jacob-rn-wallace/maha-rover/docs/images/viewshed-ring-preview.png

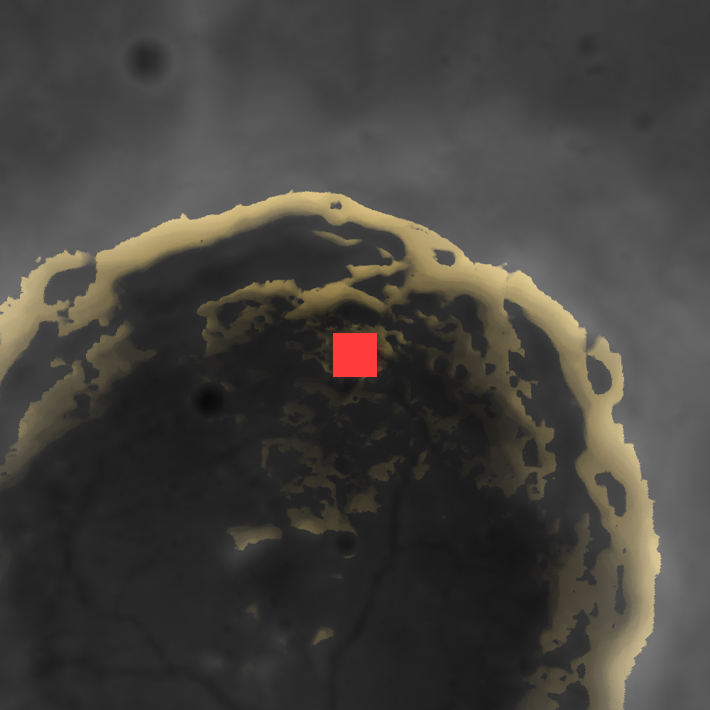
docs/images/viewshed-ring-preview.png
