jacob-rn-wallace/maha-rover/docs/sim-spec.md

# Browser simulation of al-maha on the lunar surface

**Goal (owner, 2026-11-08):** nothing can be bought or physically tested for the foreseeable future, so the current goal is a
high-fidelity simulation of the rover on the lunar surface that anyone can run and drive in a browser from GitHub (in spirit
like PUTvision/LunarSim, which is a Unity and ROS 2 Linux binary; this one is a static web page). Fidelity first, then
optimisation, then phones (owner's order).

## Architecture (decided by the assistant, owner deferred the choice)
| Part | Choice | Why |
|---|---|---|
| Rendering | three.js (WebGL2) | mature, runs on GitHub Pages as a static site, glTF native |
| Physics | Rapier (WASM, `@dimforge/rapier3d-compat`) | deterministic, fast, revolute and prismatic joints, heightfield and trimesh colliders, runs in a worker later |
| Model | glTF binary exported from the build123d CAD | the CAD stays the single source of truth: `hardware/sim/export_sim.py` |
| Build | Vite + TypeScript, built by `.github/workflows/pages.yml` | repo Settings > Pages > Source "GitHub Actions" is the one manual step |
| Fidelity-critical models | written in TypeScript, unit-checked against the docs | wheel-soil contact, the differential, the motor, power, camera |

## What is in the repo now (phase 1)
- `hardware/sim/export_sim.py` splits the assembly (187 parts, 50.9k triangles) into 9 rigid bodies and writes
  `sim/public/rover.glb` (1.7 MB) and `sim/public/rover.json` (joints, masses, centres of mass, inertia, camera).
  Bodies: chassis; link plate L and R (each with its two motors and a differential side gear); four wheels; mast pan; camera head.
  Body masses come from `hardware/mass/replica.py` (total 9.58 kg, as `docs/replica-mass.md`), the inertia from the meshes at uniform density.
- `sim/` is the web app: it loads the model on a placeholder plane and exercises every joint (pan, tilt, differential links, wheels).
- Axes: glTF Y up, metres; rover X forward stays X, rover Y (left) becomes -Z, rover Z (up) becomes Y.

## Visual layer (not in the CAD checks or the mass budget)
`hardware/sim/export_sim.py` and `hardware/sim/detail.py` add detail to the exported model only, so the CAD, its fit checks and the 9.58 kg estimate stay as they are:
- T-slot profiles (20 x 20, 20 x 40, 40 x 40: slots, diagonal webs, bore) in place of the plain extrusion boxes, with drilled holes kept; typical catalogue slot sizes, ASSUMPTION.
- Real-world materials by part (cast and sheet aluminium, anodised T-slot, black plastic, black cord, glossy dark cells, ASA wheels); the finishes are ASSUMPTIONS.
- Head and base: rounded vertical edges and a lid seam on the pan base box (seam 15 mm below the top, Takachi cover height) with four lid screws; a lid seam 10 mm behind the front face of the camera box (ASSUMPTION, not from the drawing); a PG7 hex gland with a domed cap nut; the lens with a grooved focus ring, front glass and retaining ring; two M5 bolts through the bracket web (positions ASSUMPTION).
- No Rashid-only features are added (owner, 2026-11-08).

## Lunar look (`sim/src/lunar.ts`, first version)
A low sun (14 degrees elevation, a parameter), hard shadows from a 4096 shadow map, a black sky with 4000 seeded stars, a reflection environment of black sky over sunlit regolith (so metals reflect the ground and not a room), and a flat
ground with procedural multi-scale regolith albedo and bump. Look-development values, not measurements: the albedo (about 0.12 to 0.2 effective) and the sun and exposure settings are choices. No craters, rocks or relief yet (phase 3's terrain), no earthshine, no dust.

## Phase 2: driving physics (done 2026-11-08, `sim/src/physics.ts`)
Rapier at 480 Hz fixed steps, lunar gravity 1.62 m/s2, flat ground. Nine rigid bodies from `rover.json`, with the CAD's mass, centre of mass and inertia tensor (mesh-derived, uniform density).
- **Differential:** the two link plates are separate revolute joints on the chassis, coupled by a stiff spring and damper so that angle L + angle R = 0 (k = 600 N.m/rad, c = 6 N.m.s/rad, tuned for critical damping of the sum mode; not gears, so friction and backlash are not modelled).
- **Drive:** each wheel has the Pololu 37D #4746 model from `docs/drive-spec.md`: R = 12 V / 5.5 A = 2.18 ohm, back-EMF constant 0.0111 V.s/rad from 76 rpm and 0.2 A no load, gearbox efficiency 0.75 (the value the datasheet's 0.59 N.m at 0.74 A implies), 7.4 V pack, current cap 1.6 A, shorted-terminal braking at zero duty. The motor rotor's inertia seen through the 131:1 gearbox (0.017 kg.m2, from an ASSUMED 1e-6 kg.m2 rotor) is added to each wheel.
- **Wheels:** collision shapes from the CAD mesh: a rim cylinder and 14 convex grouser hulls (plates thickened from 0.8 to 3 mm to stop tunnelling). Wheels collide with the ground only. Ground friction 0.8 and wheel 0.9 are the flat-plane placeholders (`?flat=1`); on the terrain the soil model below replaces them.
- **Mast:** pan (limit +-160 degrees, the design's 320 degree stop) and tilt (+-90) servos as PD loops, torque capped at the STS3215's 1.91 N.m stall, target slewed at its 52 rpm no-load speed; gains are tuning choices. The mast and head have no collision shapes yet.
- **Chassis collision:** the convex hull of the fixed structure on a 6 mm grid.

Scripted check (`?test=1`, 7.4 V, flat ground, grouser tip radius 115 mm):
| test | result |
|---|---|
| parked 5 s | still: 0.001 m/s, motor currents under 0.03 A |
| full throttle 6 s | steady 0.53 m/s |
| brake from speed | stops in about 1 s, no tipping |
| full turn command | spins in place at 102 deg/s (clockwise for a right turn), about 35% wheel slip |
| mast pan and tilt | reach +160 and +90 degrees |

**What the first runs showed about the design:**
- **Speed:** 0.53 m/s at full duty, above `drive-spec.md`'s 0.49 m/s no-load figure, because that used the 100 mm rim radius and the wheel rolls on its 115 mm grouser tips on hard ground (derived: 47 rpm x 0.115 m x 2 pi = 0.566 m/s before slip). On soft soil the effective radius will be smaller.
- **Braking tips the rover:** it tips nose-over if it decelerates harder than about 0.68 x g = 1.1 m/s2 on the Moon (CAD centre of mass z 235 mm, x +23 mm, half wheelbase 136.5 mm; the threshold scales with g). With zero duty the 37D shorts its terminals and a full brake through the 1.6 A cap is about 5 m/s2; the first test flipped to pitch -100 degrees. The sim limits duty change to 1.5 per second (about 0.8 m/s2). The real motor controller firmware needs the same deceleration limit; this is a finding for the electronics, not only the sim.
- **Wheel spin and friction:** with the placeholder friction the rover can spin in place; with the soil model it turns at about 70 to 100 deg/s (see Soil model).

## Soil model (done 2026-11-09; `sim/src/soil.ts`, `sim/src/physics.ts`, `sim/tests/soil-check.ts`)
**Sources.** (1) Hurrell, Takehana, Tanaka, Uno, Busoud and Yoshida, "Traction Performance Evaluation for a Rashid-1 Rover Wheel", Space Science Reviews 221:37 (2025), doi 10.1007/s11214-025-01164-8 (private library S4): single-wheel tests and DEM of the Rashid-1 wheel (rim radius 100 mm, width 80 mm, 14 grousers of 20 mm, 1.18 kg) in FJS-1 lunar simulant at 25% relative density (bulk density 1740 kg/m3, angle of repose 38 degrees, cohesion 2.4 kN/m2) at the rover's load of 24.5 N per wheel on Earth, and 4.1 N in lunar gravity by DEM.
Its Table 4 (lunar columns) is the target; its finding is that the traction coefficient (net pull over load) is the same in lunar gravity as on Earth at the same mass while the forces scale by 1/6, so the model is per unit load. (2) Tuned parameters of the MBRSC regolith in the Advance Simulation paper (Reece pressure-sinkage model with a grouser term and the Wong shear model, Vortex Studio; private library S22): friction angle 23 degrees, cohesion 0, shear modulus K 0.036 m, sinkage exponent 1.1, weight density 15620 N/m3, kc' 0.63, kphi' 80. **Not used**: its tuned parameters fit a different simulant, its quoted test-wheel size as printed (diameter 0.1 m, width 7.5 mm, 12 grousers of 10 mm) disagrees with the Hurrell paper's wheel and with the 60 N loads in its Table III, and its untuned parameters were 40% off its own bench drawbar pull (6.2 N against 10.2 N; within about 10% after tuning, Table III). They are recorded here as the softer alternative (tan 23 degrees = 0.42, against 0.86 for FJS-1).
**Table 4, lunar, FJS-1 (slip s = (w R_rim - v) / (w R_rim)):** at 0, 10, 20, 30, 40, 50% slip: net pull / load 0.28, 0.34, 0.38, 0.42, 0.45, 0.49; wheel torque 0.22, 0.26, 0.29, 0.31, 0.32, 0.35 N.m (load 4.07 N); total sinkage 5.1, 7.8, 11.2, 15.6, 20.5, 26.5 mm. Its Fig. 5 shows the experiment 10 to 15% below the DEM at 30 to 50% slip; the DEM is used as it is the only lunar-gravity result.
**Derived here (ASSUMPTION where marked):** gross thrust is the torque over R (0.54 to 0.86 of the load) and the motion resistance is gross thrust minus net pull (0.26 to 0.37 of the load). The paper's slip is referred to the rim, but the grousers set the kinematic radius, so thrust at "0% slip" is not zero; referring slip to the grouser tips, s_e = 1 - (1 - s) / 1.2, thrust is zero at s_e = 0 and a least-squares fit gives a Janosi-Hanamoto curve T / load = 0.86 (1 - exp(-s_e / 0.18)) and a resistance of (0.237 + 0.229 s_e) load; the net pull is within 0.04 of the load at all six points. tan(38 degrees) = 0.78 against 0.86: the cohesion makes up the difference. The flight wheel's grousers are 15 mm (tip radius 115 mm), the test wheel's 20 mm: the same curve is used with the sim wheel's own tip radius (**ASSUMPTION**: the shear curve does not depend on the grouser length).
**In the sim:** Coulomb friction is off at the wheels (friction 0, combine rule minimum); each substep the contact normal load of each wheel is read from the Rapier contacts (smoothed over 30 ms), the tip-referred slip from the wheel's rim speed and hub velocity, and the soil force applied: thrust and side force at the contact point as one combined-slip vector of magnitude N T(s), resistance at the hub opposing its motion. The reaction torque on the wheel comes out of the thrust acting at the contact point, so the motor sees the load. Sinkage is not simulated (rigid ground, the wheel rides on its rim; the grouser hulls do not collide with the ground and are kept for rocks); the paper's sinkage for the current slip is shown in the HUD. Rapier's reported contact impulses sum to (n + 1) / n times the weight for n = 8 solver iterations (measured), so loads are scaled by n / (n + 1).
**Checks (`npm run check:soil`, 28 s simulated in about 5 s of Node time):** settled wheel loads 4.1, 4.2, 3.6, 3.7 N (sum 15.6 N, weight 15.5 N); full throttle on flat ground 0.515 m/s at 7% slip (Coulomb: 0.54); coasting and braking stop it; turn in place 65 to 100 deg/s (Coulomb: 190); a 12 s drive up a ramp of 5, 10, 15, 20 degrees: 0.49, 0.45, 0.42, 0.36 m/s at slip 10, 15, 22, 34%; at 25 degrees the rover tips over backwards (the static tip angle is 26 degrees, `docs/mass-budget.md`). On the real terrain `?test=1&terrain=1`: 0.52 m/s, turn -71 deg/s, brakes to rest. The start-up transient seen with rigid grousers (pitch 6 degrees in the first second) is gone.
**Not modelled:** sinkage and its effect on the chassis ground clearance, wheel tracks, slip sinkage, lateral soil flow, bulldozing against rocks, dust; gravity scaling beyond the paper's finding; the difference between FJS-1 and real lunar regolith at the landing site.

## Rocks (done 2026-11-09; `sim/src/rocks.ts`, `npm run check:rocks`, `npm run check:soil -- rocks|field`)
**Sources.** (1) Joulaud et al., Space Science Reviews 220:65 (2024): 7232 boulders mapped by hand on LROC NAC images in the 8 km ellipse FR-11 in Atlas crater, **144 per km2**. Objects under about 1.5 to 2 m cannot be detected at 0.5 to 1 m/px, so the count is of boulders of about 2 m and more; the fields lie near the ellipse centre (south-west, by a large degraded crater), in the north-east and on topographic highs, the plains elsewhere being poor. The paper gives no size distribution (checked in full); the mapped positions are only in its figures. (2) Bandfield et al., JGR Planets 116, E00H02 (2011), after Cintala and McBride (1995): from 769 blocks (2 to 11 m and more) counted on LROC images of the central peak of King Crater, the cumulative areal fraction of rocks of diameter d or more is **c = 0.082 d^-1.326** (d in metres); their counts under 3 m are probably incomplete. The number of rocks of d or more per m2 follows as N = A d^-3.326, A = 4 K b / (pi (b + 2)), c = K d^-b.
**Model.** The law is scaled so that N(2 m) = 144 per km2: K = 0.00285 (the areal fraction of rocks of 1 m and more, 0.285%). Rocks of 0.12 to 14 m are generated deterministically per grid cell (seeded by the cell, a Poisson count, diameters by inverse transform of the truncated power law), in three tiers drawn as instanced meshes: stones 0.12 to 0.5 m within 50 m (about 3700 on screen), rocks 0.5 to 2 m within 300 m (2000), boulders 2 to 14 m within 1.5 km (1000); rebuilt in 5 to 20 ms when the rover has moved 16, 64 or 256 m. Shapes are lumpy ellipsoids (vertical axis 0.35 to 0.7 of the width), buried by 20 to 40% of their height, grey 0.75 to 1.25 of an albedo of about 0.17, lit by the terrain shadow textures. The spawn point is kept clear.
Physics: convex hulls of the rocks of 0.2 m and more (the smaller stones are drawn only): stones within 8 m, rocks within 30 m, boulders within 60 m of the rover (about 100 to 400 colliders), friction 0.6 with the maximum combine rule (so the wheels, friction 0 under the soil model, grip them), colliding with the chassis, wheels and grousers; the soil model sees only the ground's contacts. `?rocks=0` leaves them out. **T** stands the rover upright where it is, keeping its heading.
**ASSUMPTIONS (not in the sources):** (1) King Crater's exponent holds on the Atlas floor and down to 0.12 m, a factor of 17 below the smallest mapped boulders (the counted areal fraction of rocks of 12 cm and more is then about 2.5 to 4.7%, probably more than the real plains carry: a Golombek and Rapp style law that saturates at small sizes would give fewer); (2) the 144 per km2 is complete at 2 m (complete at 3 m would give K = 0.011, four times the rocks); (3) the density is a smooth random field (log-normal, fields a few hundred metres across) times a slope factor (1 + (slope / 8 degrees)^2, at most 5), normalised to the tile mean: boulder fields exist, but their mapped places are not used; (4) shapes and burial. Over the whole 23 km2 of the generator's area the count of rocks of 2 m and more is 145 per km2 (target 144); the smaller sizes, counted over smaller areas, scatter with the density field.
**Diviner rock abundance (the units question of the hand-off):** the cumulative law with K = 0.00285 gives 0.285% of the surface covered by rocks of 1 m and more; the Diviner map reports the areal fraction of rocks (Bandfield: mostly 0.002 to 0.005 on the Moon, so reported as fractions or percent of 1). Flahaut et al. 2024 give 0.0029 for FR-11, which agrees if it is a fraction (0.29%; the column's "(%)" is a mislabel like that of its slope column, a fraction by its footnote). Joulaud et al. give 0.029%, ten times less: probably a slip. Unresolved in the papers themselves; the agreement above is a plausibility check, not a proof (K rests on assumption 2).
**Results (the rover on flat ground, blind at full throttle, `npm run check:soil -- field|rocks`):** a 6 cm high rock is crossed with a pitch excursion of 35 degrees; a rock as high as the wheel radius (10 cm) stops the rover and tips it onto its nose, as does a 20 cm rock. This follows from the drive: a 1.6 A motor stalls at about 13 N at the wheel, and four of them against an immovable obstacle (53 N) exceed what the 15.5 N rover can take without tipping; a design consequence: the motor controller needs stall or obstacle detection, not only the current cap. In the generated field, from four starts, the rover drove 53 m, was stuck at 9 m, and tipped twice within 16 m (denser patches): the field is drivable only by steering round the larger stones.
**Not modelled:** rock shadows beyond the 4 m shadow map round the rover (rocks only receive the terrain shadows), rock albedo and shape variety (one lumpy mesh), rocks that roll, regolith dust, clustering round craters, and the rocks beyond the tile (the ring has none).

## Terrain data (decided 2026-11-08)
Real terrain for the high-detail area: a 5 x 5 km window of the LROC Atlas crater DTM (2 m posts, `hardware/sim/terrain/atlas_tile.py`, tile in `sim/public/terrain/`). Beyond it, a low-detail ring (LOLA, 237 m posts); the physics runs only on a patch of about 30 m around the rover
built from the tile plus procedural detail (owner's layering, 2026-11-08).
- **Site, and the criteria behind it:** the DTM is three strips (stereo swaths) with a large empty north-west part (about 43% of the file has no data), so the paper's prime ellipse is not covered and the Hakuto-R impact point (47.581 N, 44.094 E) is outside the raster.
  `hardware/sim/terrain/site_select.py` scores all 828 fully covered 5 x 5 km windows with the method and numbers of the Rashid-1 site-selection paper (Flahaut et al., Space Science Reviews 220:53, 2024, in the private paper library): slopes on 8 m cells (their source is the 7.4 m/px Kaguya TC mosaic),
  at least 95% of slopes under 15 degrees (their verification step), mean slope at most 7.3 degrees (the highest of their Atlas candidate ellipses, whose mean slopes are 6.8 to 7.3 with standard deviation 4.2 to 4.6 and 94 to 96% of pixels under 15 degrees), nearest to their prime ellipse FR-11 (47.53 N, 44.33 E; 6.8 degrees, 96%).
  219 windows pass. The nearest is centred on **47.5676 N, 44.8102 E**, 10.0 km from FR-11: mean slope 6.2 degrees, 97.9% under 15, 30% under 4, relief 305 m (the earlier criteria, which I invented, rejected this for its relief). The tile has a thin vertical stripe near its east edge, probably a seam between data strips.
  The paper's ellipse is an 8 km circle, the sandbox a 5 km square, so the statistics are close but not the same. The windows' slopes come from stereo-matched 2 m posts averaged to 8 m, a different source from the paper's, so they are comparable, not identical.
- **What the paper also gives for the procedural detail (Atlas ellipse FR-11, from NAC mapping):** 7232 mapped boulders in the 8 km ellipse, 144 per km2; Diviner rock abundance low (0.029% in the boulder paper, 0.0029 in the site paper's table: the units differ or one is a typo, to be checked); mean Mini-RF CPR 0.56;
  median regolith thickness 1.2 m (quartiles 1 and 1.7, range 0.5 to 20.2 m) from 293 mapped small craters, so a thin regolith; the ellipse is "generally devoid of fresh impact craters, and dominated by gently rolling plains", with boulder fields near its edges and near large degraded craters (Joulaud et al., Space Science Reviews 220:65, 2024, doi 10.1007/s11214-024-01101-1).
  Boulder size distribution and minimum mapped size were not found in the pages read: needed for the rock model.
- **Viewshed and ring (done 2026-11-09, `hardware/sim/terrain/viewshed.py`, outputs `sim/public/terrain/ring.png`, `ring_mask.png`, `ring.json`, preview `docs/images/viewshed-ring-preview.png`):** a combined elevation model (Atlas 2 m posts block-averaged to 8 m where covered, LDEM_128 elsewhere; on the Atlas area the two differ by a mean of -1.3 m, median -0.3 m, standard deviation 17 m, so no datum shift is applied) is swept from 33 observers (20 on the tile edge, a 3 x 3 lattice at 1.5 km inside) with the camera 0.7 m above ground and the lunar curvature (R 1737.4 km) in the elevation-angle test, 0.05 degree ray spacing, 8 m steps to 16 km and 48 m beyond, to 100 km.
  The ring is a polar grid about the tile centre (1440 azimuth bins, 848 range bins growing by 0.44% per bin from 2.5 km, so cells stay square: 11 m at the tile edge, about 220 m at 50 km, matching the LDEM's 237 m). Each cell stores its height and the fraction of observers that see it.
  Result: 30.7% of the 1.22 million ring cells (375,108) are seen from at least one observer, out to 74 km (so the 100 km limit does not clip it); what is seen is the crater's inner walls and rim, a broken band, and the flat floor between is hidden. Per observer the visible cells range from 30,000 to 196,000.
  Limits: eye height only (a free camera above 0.7 m would see more); the ring beyond the tile edge is 8 m data where the sim's tile is 2 m; where the Atlas ends and the LDEM takes over the model is joined without a step (fixed 2026-11-09, see Seams below); the 0.25 degree azimuth bins are about 320 m wide at 74 km.
- **In the sim (done 2026-11-09; `sim/src/terrain.ts`, `terrainView.ts`, `physics.ts`):** the world frame is x east, y up, z south, origin at the tile centre at the tile's centre height, and the heights carry the lunar curvature (y = h - d^2 / 2R inside the tile, the exact sphere in the ring). The tile is smoothed with a Gaussian of 2 posts (4 m; the product's precision is 2.89 m) and sampled bicubically; below that scale, five octaves of deterministic procedural noise (8, 4, 2, 1, 0.5 m wavelength, amplitude 0.006 x wavelength, each octave's lattice turned by its own angle) are added: **ASSUMPTION**, a look-development roughness of a few millimetres to a few centimetres, to be replaced from the soil and rock data.
  The rover spawns on the flattest spot within 400 m of the centre (worst slope to eight neighbours 6 m away; now x -200 m, z +160 m, i.e. 160 m south-west). Visuals: a geometry clipmap of four levels (0.25 m cells over 64 m, 1 m over 256 m, 4 m over 1 km, a fixed 20 m level over the tile), world-aligned lattices rebuilt in steps of 4, 16 and 80 m, holes where the finer level lies and the finer level's edge vertices stitched to the coarser level's linear interpolation (no cracks); the ring mesh beyond the tile uses only the cells some observer sees, plus a one-cell margin (796,000 triangles). Logarithmic depth buffer, camera far plane 200 km, stars drawn as a background layer.
  Physics: a Rapier heightfield collider of 32 m at 0.25 m cells, rebuilt (snapped to 4 m) when the rover is 4 m from its centre, with `FIX_INTERNAL_EDGES` (without it a rover on even a perfectly flat heightfield wheelies and stalls); four hard walls 20 m inside the tile edge, and the HUD warns within 100 m of them (owner's "soft boundary" is only the warning for now).
  Checked 2026-11-09 (headless Chrome, Coulomb friction): `?test=1&terrain=1` drove at 0.54 m/s, turned at -93 deg/s, braked to rest, mast moved; 20 m driven through five collider re-centrings with steady speed. A start-up transient (pitch up to 6 degrees) was traced to the rigid grousers hopping on the heightfield and is gone with the soil model (below).
  URL switches: `?flat=1` the old flat plane (`?test=1` implies it unless `?terrain=1`), `?soil=0` Coulomb friction on the terrain (`?soil=1` the soil model on the flat plane), `?detail=0` no procedural roughness, `?smooth=posts` the smoothing sigma. `?cam=` is now relative to the spawn point.
  Seams and shadows (done 2026-11-09): (1) The ring showed a lit line and a block pattern west of the tile. The line was a step in the elevation model where the Atlas ends (the Atlas and LDEM differ by 17 m, standard deviation): `viewshed.py` now shifts the LDEM by the Atlas-minus-LDEM difference averaged over 200 m round the Atlas edge, fading out over 1.5 km (and smoothly where Atlas cells thin out: a hard cut at the edge of the averaging made a one-cell spike, the line that remained), and eases the Atlas's outer 150 m onto the same surface. The blocks were the LDEM's 237 m pixels sampled bilinearly: now a cubic spline. A faint band where the surface detail changes from 8 m to 237 m data remains. (2) The tile mesh's fixed level is now 10 m (was 20 m), the ring sinks by up to 2 m under the tile, and the ring is always drawn within 150 m of the tile: the ring had poked through the sagging tile mesh at the edge. Ring cells no observer can see are not drawn at all: from a camera far above the rover the ground beyond the tile shows holes (by design: the rover's eye is at 0.7 m).
  Terrain shadows: `hardware/sim/terrain/shadow.py` sweeps the sun direction over the elevation model (Atlas tile, then the 8 m and 48 m grids) and writes two lit-fraction textures (`shadow_tile.png`: the tile at 4 m, `shadow_coarse.png`: 100 km round at 100 m); `terrainShadow.ts` multiplies them into the sun's light on the terrain and on the rover's materials. They hold the fixed sun (14 degrees elevation, azimuth 40); if `lunar.ts` uses another, they are not applied. 0.4% of the tile and 3.5% of the 200 km square are in shadow (the tile is gentle ground under a 14 degree sun: shadows lie in the crater rim's lee, along the tile's north-east edge, and in hollows). Soft edge 2 m on the shadow side (a fixed simplification of the 0.53 degree sun disc); lunar curvature not in the shadow geometry; blockers beyond 100 km not modelled. The renderer's own shadow map still covers the 4 m round the rover.
  Not done: no craters or rocks, the regolith bump texture shows water-like ripples at grazing angles and a regular weave from above (already so on the flat plane: needs macro variation and a distance fade). `?hide=0,1,2,3,4` hides a terrain level (3 is the tile) or the ring (4): for finding seams.
- **Accuracy:** the product states 2.89 m vertical precision and 3.47 to 13.0 m RMS against LOLA tracks, so small features come from procedural detail, not from the data.
- **Licence:** public domain per https://lroc.im-ldi.com/about/terms (the file came from pds.lroc.im-ldi.com); credit NASA/GSFC/Arizona State University. Entered in `NOTICE.md`.
- **Data handling:** the 1.25 GB source file stays outside the repo (the owner's `~/Downloads`; suggested home `~/lunar-data/`); only the cropped 16 bit tile (6 MB) is committed.

## Fidelity criteria (proposed; the owner has not confirmed them)
1. **Geometry:** the sim rover is the CAD, to the millimetre; wheels have their 14 grousers as real collision geometry.
2. **Mass:** per-body mass and centre of mass from `replica.py`; lunar gravity 1.62 m/s2.
3. **Mechanism:** the passive differential is simulated as the mechanism it is (links coupled, angle L = -angle R), not a rocker; skid steering emerges from four driven wheels.
4. **Drive:** each wheel driven by the Pololu 37D motor model (torque-speed line, 1.6 A current cap, gear ratio 131:1) from `docs/drive-spec.md`; the battery sag and power from `docs/power-spec.md`.
5. **Terrain:** procedural lunar surface (crater size-frequency distribution, rocks, regolith relief), real lunar lighting (sun at a low elevation, black sky, hard shadows, earthshine optional), regolith appearance; wheel-soil interaction through a simple Bekker-type sinkage and slip model, tuned to published lunar regolith values (cited when added).
6. **Mast and camera:** pan and tilt servos with speed and range limits; the HQ camera view (field of view, resolution, no auto-exposure tricks) shown as a picture-in-picture.
7. **Telemetry:** speed, wheel slip, link-plate angle, tilt, power draw, battery state, solar input.
8. **Validation:** static tip angles and the 20 degree slope climb from `replica.py` and `docs/suspension-spec.md` must reproduce in the sim.

## Phases
1. **Sim-ready design (done):** exporter, JSON, viewer scaffold, Pages workflow.
2. **Rover on flat ground (done, see above):** Rapier bodies and joints from the JSON, differential constraint, wheel motors, keyboard and gamepad driving, chase camera.
3. **Terrain and lighting:** lunar sun, black sky, procedural terrain with craters and rocks, lunar gravity, soil model.
4. **Mast camera and telemetry:** pan-tilt control, camera PiP, HUD, power model.
5. **Publish:** GitHub Pages, README with controls.
6. **Optimise (later):** meshopt or Draco, instancing, LOD, shadow budget, a worker for physics, touch controls, phone profile.

## Open items and unverified
- Camera field of view: 76.6 x 61.4 degrees from the IMX477's 6.287 x 4.712 mm image area (Raspberry Pi camera documentation, read 2026-11-09) and the 4 mm lens's focal length (one retailer's listing: the lens figure is unverified). No distortion, vignetting, noise or auto-exposure; the view renders at the window's resolution, not the sensor's 4056 x 3040.
- Pan range of the pan servo and servo speeds are assumptions.
- The wheel is a single solid mesh; its collision shape is the full mesh (grousers included); the cost of a trimesh wheel in Rapier is untested.
- The differential's internal friction and backlash are not modelled yet.
- Soil parameters: now from Hurrell et al. 2025 (see Soil model). Still FJS-1 simulant at 25% relative density, not lunar regolith: the paper itself says the flight wheel's sinkage needs the final wheel model.
- The camera-link cable is fixed to the chassis in the model; it does not follow the pan yet.
- Physics inertia is mesh-derived at uniform density, so heavy small parts (motors, battery) are only right in the total mass and centre of mass.

## Mast camera and telemetry (done 2026-11-09)
- **Camera view:** a second three.js camera on the head body (position from `rover.json` `camera.position_m`, looking along the head's +x), vertical field of view 61.4 degrees at 4:3, drawn as a scissored picture-in-picture at the bottom right; **C** cycles small, large, off. (The exporter had put the camera 161 mm behind the tilt axis: it multiplied a value already in metres by 1e-3 a second time; fixed in `export_sim.py` and the JSON patched to the same value, 0.0537 m ahead of the axis, without regenerating the model.)
- **Power model (`sim/src/power.ts`, HUD line):** the 2S2P 30Q pack of `power-spec.md` (6 Ah), drive current as the sum of duty x motor current, Pi and camera 0.8 A, servos 0.3 A moving or 0.04 A holding, solar 9.6 W per side times the cosine of the sun's incidence on each leaning panel times 0.9 charger efficiency. **ASSUMPTIONS, not sourced:** the linear open-circuit curve 8.4 to 6.4 V, pack resistance 0.05 ohm, the servo currents, the charger efficiency. The solar input ignores shadows (terrain and rover) and uses the fixed sun. Flat driving draws about 2 A (14 W); the HUD shows state of charge, volts, load, solar input and time left.
- Telemetry on the HUD: speed, slip, soil slip and sinkage, pitch and roll, link angles, mast pan and tilt, motor currents, battery, position.

## Polish round (2026-11-09)
- **Regolith texture:** the ground texture's value-noise octaves are now sampled through integer rotation matrices (each lattice turned by its own angle, still tiling), the albedo and bump use different seeds, the bump is weaker (0.6, was 3.0) and the two lowest octaves are gone from the 2.5 m tile; a second, low-frequency texture is sampled twice in the ground shader at about 31 m and 113 m and multiplies the albedo, so the repeat no longer shows from a few metres up. The water-like ripples at grazing angles are gone in the headless screenshots. Left: the 2.5 m repeat of the bump is still visible looking straight down from 30 m.
- **Changeable sun:** `?sun=elevation,azimuth` (degrees; azimuth counterclockwise from east, 90 = north). The precomputed shadow textures only fit 14, 40; for any other sun the browser runs the same horizon sweep over the terrain it draws (`computeTerrainShadow`, 8 m grid for the tile, 150 m for the 200 km map, blockers to 20 km beyond each map, lunar curvature included), a few seconds at load. Checked against the precomputed textures for 14, 40: the same shadows apart from small differences on the far ridges. No sun motion during a session, no earthshine.
- **Tilt guard (replaces the planned stall protection):** the drive is cut and braked while the chassis is tilted past 25 degrees (pitch or roll) until it is back under 15 degrees (a firmware rule, an IMU on the Pi: ASSUMPTION; the HUD says so; T stands the rover upright). Finding: a wheel-high rock is not a motor stall. The motors stay near no-load current while the rover rides up the rock and pitches over (currents 0.2 to 0.3 A at the moment the pitch passes 40 degrees), so a current-based stall rule never fired. With the guard, the 20 degree ramp still climbs (4.1 m in 12 s), the 25 degree ramp and the 0.1 m rock no longer flip the rover (peak pitch 25 degrees), and the 0.2 m rock lifts the front to 48 degrees but the rover stays upright. `RoverPhysics.tiltGuard = false` turns it off.
- **Load time:** `npm run check:load` times the start-up steps in node (no GPU): Terrain.load about 1.0 s (the PNG decodes about 0.5 s, the Gaussian smoothing about 0.5 s after a cache-friendlier rewrite), the first clipmap build 0.19 s, the ring mesh 0.74 s (792,000 triangles); a clipmap rebuild after 4 m of travel costs about 66 ms of CPU at its worst (all four levels at once). Not measured: GPU upload, shader compile, network (the terrain files are about 12 MB), or any real phone.
- **Phones and touch:** with a coarse primary pointer, or `?touch=1`, two on-screen sticks appear (left: drive and steer, right: mast pan and tilt) with buttons for the camera view and for standing the rover upright; the pixel ratio is capped at 1.25, the HUD is three lines (tap it for the full readout) and the camera view sits at the top right. Checked only as a headless screenshot at 844 x 390 with `?touch=1`: no real touch device, no frame-rate measurement.

## Surface realism: what other lunar simulators do (2026-11-09; web search, abstracts and the pages that opened, not full papers)
Sources: OmniLRS (arXiv 2309.08997; Isaac Sim, path tracing; its repository is named LunarSim too, but the paper called LunarSim is the Poznan one below); the Chrono::Sensor lunar regolith model (arXiv 2410.04371); Menon, Walker, Szafir, Fong and Burns, 'Efficient Photometric Models of the Lunar Regolith for Virtual Reality Simulation' (a 2019 one-page poster, CU Boulder and NASA Ames, in the private repo's `reference-material/`, read), LunarSim by Pieczynski, Ptak, Kraft and Drapikowski (Applied Sciences 13(22), 12401, 2023, doi 10.3390/app132212401, private repo `papers/`, read); the SurRender and Lunar-G2R papers (snippets); NASA's Gazebo rover simulator (NTRS 20190027571, snippet).
- **No tiled texture.** OmniLRS builds geometry: 1 m per post DEMs, upsampled by GAN and then crater-decorated to about 4 cm per pixel (2.5 cm in its large-scale mode); craters of 0.5 to 10 m from 100 half-profiles taken from SLDEM, normalised and fitted with cubic splines, placed with hard-core Poisson processes in three density classes; rocks from photogrammetry and Apollo scans with the detail baked into normal maps, placed by Poisson and Thomas point processes. It states that no public lunar material exists and that its gravel textures from Polyhaven are not lunar. NASA's Gazebo simulator does the same (fractal upsampling plus craters and rocks from size-frequency laws). Chrono::Sensor uses no normal map at all: the micro-relief is real geometry (one voxel per particle).
- **The regolith is not Lambertian.** The standard model is Hapke's; real-time versions use Lommel-Seeliger single scattering plus a shadow-hiding opposition surge (Chrono's Table I: single-scattering albedo 0.03257, B0 = 1.80238, h = 0.07145, roughness 23.4 degrees, filling factor 0.3; PANGU-derived values quoted by another paper: albedo 0.33, h 0.05, B0 0.95). The consequences visible in photographs: no darkening towards the limb, a bright flat look when the sun is behind the camera, and a washed-out texture looking along the sun. Lunar-G2R (2026) argues that a spatially uniform BRDF is itself a limit and predicts per-point BRDF parameters from a DEM.
- **Path tracing** (OmniLRS) gives the pitch-black shadows and hard contrast; the cameras add sensor noise, vignetting and saturation (Chrono: Poisson-Gaussian noise, cos^4 vignetting, a 16 bit HDR response); OmniLRS lists lens flare, noise and saturation as sim-to-real gaps it does not model.
Applied here (2026-11-09, `sim/src/regolith.ts`, `terrain.ts`): (1) the tiled texture is gone; the albedo mottling (metre to 90 m patches, finer grain) and the centimetre-scale normal relief are world-space noise evaluated per pixel, octaves fading under two pixel footprints; (2) the sun's light is weighted Lommel-Seeliger with Chrono's opposition surge (normalised to 1 at a phase angle of 30 degrees, weight capped at 3), on the ground and on the rocks; (3) small craters from 0.75 to 48 m (six tiers) in `Terrain.craters`, by an equilibrium size law (cumulative N = 3% x 1.54 D^-2 per m2: the 1.54 saturation law is from memory, not read, and 3% is a look choice), bowl and rim profile, depth/diameter 0.04 to 0.20, deterministic per cell, shared by mesh, collider and rock placement. Not done: half-crater profiles from real data, photogrammetry rocks, camera noise and vignetting on the mast view, per-point albedo from the DEM, the Hapke roughness term. The Chrono parameters are fitted for 30 S to 30 N and this site is at 47.6 N.

Read later (2026-11-09): **LunarSim (Pieczynski et al. 2023)** is a Unity scene of 950 x 950 m with hand-made craters, hand-placed rock models, blended albedo and normal textures and screen-space post effects (colour grading, ambient occlusion, contact shadows, reflections); no photometric model, and it names more realistic textures as future work: nothing there beyond what is applied above. **The Colorado poster** confirms the approach: sun as one directional light (a slightly reddish 255, 235, 238), the base terrain from LROC NAC elevation models fractally expanded from about 0.5 m to sub-millimetre, two BRDFs (full Hapke with five parameters for Mare Imbrium from Sato et al. 2014, JGR Planets 119:1775, and the cheaper Hapke-Lommel-Seeliger with parameters from Jensen et al. 2001's night-sky model), no ray tracing because the single-scattering albedo is about 0.15; its future work lists energy-conserving normalisation (the opposition weight here is normalised by hand to 1 at 30 degrees: not energy-conserving either), normal and height maps from observed fractal parameters, and craters and boulders from size-frequency distributions (done here for craters). **Lead not followed:** Sato et al. 2014 maps the Hapke parameters over the Moon, which could replace Chrono's 30 S to 30 N values with site values for 47.6 N.

**Sato et al. 2014 read (2026-11-09; `papers/Resolved_Hapke_parameter_maps_of_the_Moon.pdf` in the private repo):** global maps at 70 S to 70 N of the Hapke parameters w, b and hS (the rest fixed: roughness 23.4 degrees, filling factor 1, coherent backscatter off, c from b, shadow-hiding amplitude B_S0 from w by a regression, its Eq. 4) from LROC WAC, 100 m per pixel. Maria: b 0.26 +- 0.01, hS 0.050 +- 0.008; highlands: b 0.23, hS 0.074 (equatorial medians). Chrono's h = 0.07145 therefore matches the highlands; the sim now uses 0.050 (maria; the Rashid sites are mare, per the site papers) with Chrono's B0 and the surge normalised at 30 degrees again (divisor 1.2835). The paper itself says hS and b, c are poorly constrained poleward of about 40 degrees (too small a range of phase angles) and interprets maps only inside 40 S to 40 N: this site is at 47.6 N, so the value is a mare value assumed to hold. The actual map pixel at the site (a PDS data product, not in the paper) was not read.

## Mast camera image: vignetting and noise (2026-11-09, `sim/src/cameraFx.ts`)
The mast view is rendered at 640 x 480 (the stream's resolution: an assumption, the sensor itself is 4056 x 3040) into a linear half-float target and passed through a shader: **cos^4 vignetting** of the field angle through the 4 mm lens over the 6.287 x 4.712 mm image area (the corner factor would be 0.26 at full strength; `?vignette=0..1`, default 0.6 as a look choice for the partly corrected image the Pi's lens-shading correction delivers), then **Poisson-Gaussian noise** in linear light (shot-noise variance = signal over a full well of 4000 electrons, plus 3 electrons of read noise: both ASSUMPTIONS, not looked up; `?noise=0` switches it off), then the display tone curve. The form follows Chrono::Sensor's camera model (arXiv 2410.04371). `?pip=0|1|2` sets the starting size of the camera view. Checked in headless screenshots against the clean render: corners visibly darker, a fine grain on the ground and none on the black sky. Not modelled: distortion (the real 4 mm lens distorts noticeably), defocus, chromatic effects, rolling shutter, auto-exposure, compression, the sensor's colour response.

**Lens distortion and auto-exposure added (2026-11-09, `cameraFx.ts`).** Distortion: radial barrel, r_ideal = r (1 + K1 r^2) over the half-diagonal, K1 = 0.08 (about 7% at the corners): an **ASSUMPTION**, a typical figure for a wide-angle fixed lens, not this lens's (the 4 mm lens is an unnamed retailer listing, `mast-spec.md`; the real lens would need measuring); the scene is rendered with the field of view widened by the corner factor so the corners are real picture (`renderFov`), and `?distort=0` or a scale turns it off or changes it. Auto-exposure: a centre-weighted mean of the linear luminance (Gaussian, sigma 0.4 of the half-height; the Pi camera stack's default metering is centre-weighted, from memory) is read back at 32 x 24 every fourth frame and a gain follows it towards a mean of 0.18 with a 0.5 s time constant, limited to 0.05 to 32; **all four numbers are assumptions**; the gain scales the signal before the noise; the camera label shows it; `?ae=0` holds it at 1. In the screenshot of the spawn view the gain settles at about 1.5. Left out: defocus, chromatic effects, rolling shutter, compression, the sensor's colour response, and any exposure-time limit (a real auto-exposure also changes the exposure time and so the motion blur).

## Performance round (2026-11-09)
- **Metal:** the aluminium, steel and anodised parts get a brushed grain computed in the shader from the part's own coordinates (`sim/src/metal.ts`; the export has no UVs): streaks along the face's long axis modulate roughness (+-0.12), albedo (+-3%) and the normal (a few degrees). Look choices, not measurements.
- **Physics in a worker:** `physicsWorker.ts` runs Rapier, the heightfield patch and the rock hulls on their own thread at their own clock (an 8 ms timer, steps capped at 50 ms of simulated time per tick) and posts a snapshot (body poses, chassis velocity, telemetry) each tick; `physicsProxy.ts` gives the page the same fields the HUD and the render loop read. The worker loads its own copy of the terrain (the page keeps one for drawing; both deterministic). Rendering no longer slows the simulation: with a slow renderer (headless software GL) the old loop advanced the physics at most 50 ms per frame, so simulated time ran slower than real time; the worker keeps real time. `?worker=0` keeps the old in-page physics; `?test=1` and the node checks always use it. Cost: the worker bundle includes three (2.2 MB, unminified-looking: it imports `rocks.ts` and `terrain.ts`) and a second copy of the tile in memory (about 50 MB). Checked on the dev server and on `vite build` + `vite preview` in headless Chrome by holding full throttle: 0.52 m/s, as in the in-page path. Not checked: a phone, the snapshot's jitter on a real display (no interpolation between snapshots).
- **Shadow budget:** the rover's shadow map is 4096 x 4096 over 4 m (1 mm per texel, 64 MB of depth): 2048 on phones (`?shadow=N` overrides). The stones tier (about 3,700 instances within 50 m) is drawn into the shadow map every frame whatever the frustum, because instanced meshes are not culled per instance: not changed.
- **Stats and scripts:** `?stats=1` adds frame rate, draw calls and triangles of the main view to the HUD (in software GL the frame-rate figure is unreliable); `?autodrive=from,to` holds full throttle between those seconds after load; `tests/cdp-shot.mjs` takes a real-time headless screenshot through the DevTools protocol (the `--virtual-time-budget` flag does not wait for workers) and prints the HUD, the chassis position and console errors.
- **Not done:** meshopt or Draco compression of `rover.glb` (1.7 MB), splitting the 2.7 MB main bundle, a smaller terrain download (about 12 MB), GPU frame times on a real device.
- **Download size (2026-11-09):** the main bundle fell from 2.7 MB to 0.66 MB (176 kB gzipped) by keeping Rapier out of the page: the motor and wheel constants moved to `constants.ts` and the in-page physics (`?worker=0`, `?test=1`) is a dynamic import (a 2.1 MB chunk loaded only then); Rapier now loads only in the worker (2.2 MB). The elevation tile `atlas_5km.png` fell from 6.0 to 2.4 MB: its low 4 bits are zeroed (`QUANT_BITS` in `atlas_tile.py`, steps of about 8 cm, error at most 4 cm) because the product's vertical precision is 2.89 m, so those bits are noise; no terracing shows in the screenshots after the smoothing, and the driving checks are unchanged. The ring (`ring.png`, 1.5 MB, 6.7 cm steps over a 4.4 km range from LDEM data 237 m apart) was left alone. Total first load now about 2.4 + 1.5 + 0.2 MB of terrain, 2.1 MB for the rover model, about 3 MB of script. **Not done:** meshopt or Draco on `rover.glb` (2.1 MB): the tool that does it (`gltf-transform`, an npm package) was not run because fetching and running an unreviewed package needs the owner's go-ahead; the viewer would also need the meshopt decoder.

## Performance round 2 (2026-11-09, after the owner's MacBook Air M2 ran the sim badly)
Nothing here was measured on a GPU (this machine only has software GL, where one frame takes seconds and the frame-rate figure means nothing); the changes follow from what the code does per frame. **Please run `?stats=1` on the M2 and report the figures** (frame rate, pixel ratio, draw calls, triangles), and try `?depth=reverse` and `?res=1`.
- **Resolution:** the pixel ratio is capped at 1.5 on desktop (was 2: a retina screen at 2 shades four times the pixels of one at 1) and is adapted while running: it steps down by 15% when the smoothed frame time exceeds 23 ms and back up by 10% when it stays under 15 ms (floor 0.5). `?res=1` fixes it. MSAA is off on screens at a device pixel ratio of 1.75 or more. Shadows use plain PCF (was PCF soft) and a 2048 map (2 mm per texel; was 4096, 64 MB).
- **Geometry:** the ring is split into 16 sectors x 6 range bands, 96 meshes, so frustum culling drops what is behind the camera: the main view's triangle count fell from 2.5 M to 1.8 M in the first screenshot. The unused UV attributes were removed from the terrain meshes.
- **Hitches:** the clipmap's height sampling for a rebuild is spread over frames (at most 4 ms a frame; the old mesh stays until the new one is complete) instead of 70 to 150 ms in one frame every 8 s at top speed.
- **Mast camera:** the scene is rendered into the camera's sensor image at a third of the frame rate (a second full pass of the scene each frame was the largest single extra cost), without MSAA; the noise, vignette and distortion pass still runs every frame; the auto-exposure meter reads back asynchronously every 18th frame (the synchronous read-back stalled the GPU) from an 8 bit target, and ignores black sky (L < 0.003) when metering (an assumption). Untested: the exposure's convergence on real hardware, because the software-GL frames were too slow to watch it settle.
- **Shaders:** the ground's fine grain and centimetre relief are skipped where a pixel is wider than 10 cm (they were faded out there anyway), and the relief uses 4 octaves instead of 5.
- **Depth buffer:** the logarithmic depth buffer writes depth in every fragment shader, which disables early-z rejection and is a known cost on tile-based GPUs such as Apple's; `?depth=reverse` swaps it for a reversed float depth buffer where EXT_clip_control exists (experimental in three r170, untested here). If it helps on the M2 it should become the default with the logarithmic buffer as the fallback.
- **Not done:** compressing `rover.glb` (see above; the compression tool could not be run), chunking the fixed 10 m tile level (500,000 triangles, always drawn), instancing or merging the draw calls of the rover (73 draw calls in all), moving the clipmap sampling into a worker.
- **Rover model compressed (2026-11-09, run by the owner's instruction):** `npx @gltf-transform/cli meshopt public/rover.glb public/rover.glb --level high` (gltf-transform 4.5.1: meshopt compression with quantised positions, unused accessors pruned) took `rover.glb` from 2.09 MB to 376 kB; the page loads it with three's `MeshoptDecoder`. Checked in a headless screenshot: the rover looks as before and nothing is logged. The physics reads `rover.json`, not the glb, so it is unaffected. **Regenerating the model with `export_sim.py` writes the uncompressed file: run the same command afterwards.**
- **Bug found in the compressed model (2026-11-09, reported by the owner: the camera sat too far over and its disk overlapped the servo):** meshopt quantisation moves each mesh's centre and scale into its node (the head node gained a translation of (9.3, 2.7, 26.2) mm and a scale), and the viewer then set every body node's position from the physics each frame, overwriting that translation: the head mesh shifted by 26 mm sideways. (Seen on the deployed site, not in my screenshots, which I had judged too coarsely.) Fixed in `main.ts`: each body now gets a pivot group at its physics origin, which the physics drives, and the glTF node hangs under it with its own local transform. Checked by rendering the same close-up of the head with the original and with the compressed file: the same picture except for 1,842 of 540,000 pixels (quantisation detail).

## Minimap and mast speed (2026-11-09, owner's requests)
- **Minimap** (`sim/src/minimap.ts`): a map of the 5 x 5 km tile, north up, drawn once from the smoothed tile as hill shading with the sim's own sun tinted by height (relative to the tile's range), with the rover as a red arrow (its heading), an orange trail of the path (a point every 3 m, last 800), a north mark, a 1 km scale bar and the rover's position in metres from the tile centre. Redrawn at 10 Hz. **M** cycles small (200 px), large (420 px) and off; `?map=0` leaves it out, `?mapmode=0|1|2` sets the start. It maps the tile only: nothing of the ring beyond. On phones it is 110 px (240 large) and the camera view sits below it.
- **Mast speed:** the pan and tilt targets used to move at the servo's no-load speed (52 rpm, 312 degrees a second) while a key was held, which whipped the head round. They now move at 35 degrees a second at full command (a stick deflects proportionally): a teleoperation choice, **ASSUMPTION**, not the original's figure and not a servo limit (`MAST_RATE_DEG` in `physics.ts`; `?mastrate=deg/s` overrides). The servo model (torque limit, PD loop) is unchanged. Check: three seconds of pan command reach 104 degrees, tilt reaches its 90 degree limit.
- **Wordmark in the HUD (2026-11-09):** the text name at the top left is replaced by the project wordmark (`graphic-design/wordmark/almaha-wordmark.svg`, recoloured white for the dark panel as `sim/public/almaha-wordmark-white.svg`, 46 px high; the image's alt text carries the name in Arabic and Latin). The readouts sit under it. The browser tab title is still text. (The CDP screenshot script now deletes its Chrome profile on exit: each run left about 100 MB in `/tmp`, 37 of them filled the disk quota.)
- **Resolution cap (2026-11-09, after the owner's 4K monitor slowed the sim to a crawl):** the drawing buffer is capped at 2.1 million pixels (a 1080p frame; `?maxpx=megapixels` changes it), whatever the window or monitor, and the browser scales it up to the window; the cap is recomputed every frame, so it follows the window between monitors. A window of 3840 x 2160 CSS pixels draws a 1932 x 1086 buffer (checked in headless Chrome). It sits under the earlier limits (pixel ratio at most 1.5, 1.25 on phones) and the adaptive step-down on slow frames; `?res=` still fixes the ratio outright and then ignores the cap. `?stats=1` shows the buffer size. The cost is softness on a large screen: the sim is drawn at about 1080p and magnified.

## Performance log and benchmark (2026-11-09, owner's request)
- **Default resolution cap is now 1 megapixel** (about 1280 x 780; was 2.1): `?maxpx=2.1` restores 1080p. The page is magnified to fill the window.
- **Recorder** (`sim/src/perfLog.ts`): **L** starts and stops it; at the end a panel shows the headline figures and a **Download the log file** button. The JSON file holds the machine (browser string, GPU name, screen and window sizes, device pixel ratio, cores, build commit), the settings (the URL's query), a per-second summary and every frame: frame time (the gap between animation frames), main-thread time up to the main render call, pixel ratio, draw calls, triangles, position, the physics worker's smoothed step time and the snapshot rate.
- **Benchmark:** `?bench=1` runs a fixed 60 s route with the input scripted (3 s settling, 17 s straight, 4 s turning, 16 s straight, 15 s creeping with pan and tilt sweeps with the camera view on, 5 s stopped; `?benchsecs=` changes the length), with the adaptive resolution off so the pixel count is what the cap says (`&adapt=1` leaves it on), then shows the result and the download. The first 3 s are kept in the file but left out of the statistics (shader compilation). The physics runs in real time, so the route is the same whatever the frame rate, but the rover's exact path varies a little between runs. Summary of a log: `npm run bench:summary -- bench/<file>.json` (`sim/bench/README.md`).
- **Checked:** the whole chain runs in headless Chrome with software rendering (0.5 fps there, so the figures mean nothing); no real GPU numbers yet. The log leaves the machine only if the owner sends it.

### First benchmark log, and what it showed (2026-11-09; `sim/bench/23e5ffd0-almaha-perf-2026-11-09-17-52-23.json`)
The owner's MacBook (Apple GPU, 120 Hz screen, window 2009 x 1134 CSS pixels at device ratio 2, buffer 1331 x 751 after the cap): 5,366 frames in 57 s, a mean of 94 fps and a 1% low of 57 fps, main thread 1 ms a frame, physics step 1.7 ms at 124 snapshots a second; yet the owner saw it as jittery. The numbers explain it: the frame times were **not even**. The median was 8.3 ms (one 120 Hz refresh) but every third frame took about 13.6 ms (mean frame time by frame index modulo 3: 9.0, 13.6, 9.3 ms), and a quarter of the frames (26.5%) were over 1.5 x the median (standard deviation 3.9 ms): the camera view's extra scene pass, drawn on every third frame, pushed those frames past a refresh, so the screen alternated 8 and 17 ms: judder at about 40 Hz that a mean frame rate hides. A second source: the physics snapshots (124 a second) are unrelated to the screen's 120 Hz, so the newest one was drawn with uneven ages (a beat at about 4 Hz).
Fixes (all untested on a real GPU; the next log will show): (1) **frame pacing**: on a display faster than the cap, only every Nth animation frame is drawn so frames come at an even 60 Hz (`?fps=N` sets the cap, 0 = every frame), the camera view's scene pass now runs every second drawn frame (30 Hz) and the resolution controller aims at 55 fps; (2) **snapshot interpolation**: the page draws the pose 24 ms in the past, interpolated between the two snapshots that bracket that moment (`physicsProxy.ts`); the log now records the share of frames that found no later snapshot (`snapshotUnderrunPct`). The log summary also reports the frame-time standard deviation and the percentage of stutter frames (over 1.5 x the median), which is the figure to watch, not the mean: **mean fps said 94, stutter said 26%**.

### Second benchmark log (build 7071c24): the pacing fix worked

Same machine (Apple M1-class, 117.5 Hz display, window 2009x1134, buffer 1331x751). 60 fps mean, 1% low 56.9, frame time std 0.41 ms (was 3.9), stutter frames 0.1% (was 26.5%), snapshot underruns 0.1%. The owner reported it as extremely smooth. The log is `sim/bench/b7dc4f21-almaha-perf-2026-11-09-19-16-18.json`. The mean fps now sits at the cap, so headroom is not visible in this log: to see it, run `?bench=1&fps=0`.

### Draw-call merge and a chunked tile level

- Rover: parts with the default finish (the electronics, boards, fuses, frame hardware: metal 0.15, roughness 0.45) now share one `interior` material per body with per-vertex colours (`COLOR_0`), so the rover is 35 draw calls, down from 46 (chassis 20 to 9). Bodies cannot merge with each other: they move separately under physics.
- Terrain: the fixed 10 m tile level (500,000 triangles, drawn whole every frame) is cut into 10 x 10 chunk meshes over the shared vertex buffers, each with a bounding sphere, so the frustum culling drops the chunks behind the camera. Measured gain: not yet; `?bench=1&fps=0` reports the triangle count drawn.

### Camera-link cable as a rope

The cable was a fixed mesh and stayed put when the head panned. The exporter now drops that mesh and writes the cable's centre line (25 points from `headb.camera_link_path()`, radius 2.75 mm) into `rover.json` (`cable`). `sim/src/cable.ts` simulates it: Verlet points with stretch constraints plus "shape memory" constraints on every second and third neighbour, so it keeps the designed loop and swings with the head and the rover. Ends pinned: the head end to the head body (tilts and pans with it), the other to the deck gland on the chassis. Lunar gravity, damping 0.985 per 1/120 s step. Collision: rope nodes are pushed out of five boxes (mast column, pan housing, tilt servo, camera box, disk; exported as `cable.colliders`), so it wraps the mast when the head pans round; the ground and the rest of the body are not collided. Stiffness and damping are tuning choices (ASSUMPTION), not measurements. Checked by screenshot at rest and at pan -160 degrees.

### Interface layout (2026-11-09)

The sim's interface is now a layout of regions (`docs/sim-ui-layout.md`, built in `sim/src`: `layout.ts`, `ui.ts` and the files it names): a top bar with status chips, a right column with the minimap and the camera tile, a bottom-left instrument cluster, bottom-centre alerts, and a telemetry dock that is closed by default (key I). This supersedes the earlier statements in this file about the text HUD under the wordmark, the HUD's three-line phone form with tap-to-expand, the wordmark's size in the HUD, the camera view's corner placement and the minimap's phone offsets. The keys are listed behind `?`. Modes (Drive, Plan, Camera, Data; keys 1 to 4) decide the main view; C now toggles the camera as the main view instead of cycling the camera view's size. The scripted checks read the telemetry from `#hud` (the dock), and `window.__ui`, `__camview`, `__phys` and `__fx` are exposed for them.
