jacob-rn-wallace/maha-rover/docs/mast-spec.md

# Mast specification (replica)

Replica mast, head and camera, **fixed upright**. Dimensions are from the original's CAD figures
(`original-dimensions.md` 3j, derived) where they exist; the rest is the replica's own design and
ASSUMPTION. CAD and checks: `hardware/mast/mast.py`.

**Stowing and deploying are deferred** (decision 2026-11-07). The original folds the mast flat under
120 mm and springs it up on landing [S19]; the replica's mast stands fixed for now. The earlier hinged design
(pedestal, hinge pin, fold sweep) is in commit `20aec90`, and the reasons a spring hinge does not fit are in
`electronics-spec.md` (a bus-servo hinge is the likely route when stowing is wanted).

## Geometry

Revised 2026-11-07 (owner's request): **the mast is a T-slot aluminium extrusion itself.** A 40 x 40 mm extrusion stands on a
spindle flange (the whole mast turns on a pan drive in a housing on the deck, below) and carries the bent sheet bracket and head (section "Built head" below) on its top end.

**Pan base (added 2026-11-07, owner's request: the original's pan motor is in the block at the mast base; redone 2026-11-08 around a die-cast box).** `hardware/mast/base.py`: a **Takachi AL080807** IP65 die-cast aluminium box (80 x 75 x 70 mm, 347 g, gasketed, M4
cover screws; drawing AL080807 (2025): cavity 70.5 x 66.8 at the mouth, interior height 62.75, base 55 deep, cover 15 deep; stated) stands on the base plate (3 mm since the mass second pass of 2026-11-08) with its **lid on top** (z 351 to 421). The original's base block measures about 79 mm wide and 73 mm tall with its
top near z 425 (measured on Fig. 1, `original-dimensions.md` 3m): the box matches it. Inside: the pan servo (STS3215, shaft vertical on the mast axis, long side along y so the 45.2 mm body clears the 70.5 mm cavity by 0.1 mm; z 354.6 to 391.8), a coupling disc
on its upper horn, and an aluminium bearing tower (OD 52) hung under the lid holding two 30 x 42 x 7 mm bearings (6806 size) 12.6 mm apart, the upper one against the lid's underside (z 401.3 and 413.9). The aluminium spindle (tube 30/22) runs up through them and
a 36 mm hole in the lid to a 60 mm flange at z 423 to 429 on which the extrusion stands (now z 429 to 591, 162 mm, 0.30 kg, under a 6 mm end plate to z 597). No cable passes through the box or the spindle: the harness hangs outside the mast in a loose loop, as the original's does (below). The servo only turns the mast; the bearings carry the weight and bending, with the lid carrying the bearings: mast, bearings, tower, lid, four M4 cover screws, base,
box, plate. With the bearings only 12.6 mm apart the radial load at 1 g sideways is 156 N each (468 N at 3 g) from the 1.96 N.m moment, three times the earlier 30 mm spacing; far below a 6806 bearing's rating (not checked). The cables run down the extrusion slots, through the hollow
spindle bore is empty. Not designed: the lid's stiffness under that load (a 3.6 mm cast cap; a plate under it may be needed), the gasket and a seal where the spindle leaves the lid, fixing the box to the base plate (the box has two M4
external mounting holes) and the plate to the deck, the compliant joint between servo horn and disc, axial retention of the bearings, the hard stop for the 320 degree range, the cable loop. Mass: the box is 0.347 kg against 0.145 kg for the printed housing it replaces.

| Item | Value | Status |
|---|---|---|
| Extrusion | 40 x 40 mm T-slot (Misumi HFS8-4040 class, about 1.86 kg/m; catalogue entries run 1.73 to 1.90 kg/m by variant), z 354 to 597, centre 24.2 mm ahead of the front axle (x 160.7), cut square, 223 mm, 0.41 kg | position and top height derived [3j]; section ASSUMPTION |
| Base plate | 75 x 80 x 3 mm aluminium on the deck (z 348 to 351) under the die-cast box; bolted to the deck alone with 4 M4 through bolts at x = axis +-22, y +-30, over the outer gussets under the deck's overhang (the rail under the mast was removed 2026-11-08; `frame-spec.md`) | ASSUMPTION |
| Bracket (replaces neck and C-arm) | a 2 mm aluminium web with two edge flanges, z 545 to 690, on the extrusion's +y face; the flange outline is the original's arm outline traced from [S18] Fig. 1 | derived by eye [3j], [S18] |
| Head | camera housing 60 x 72 mm, z 621 to 700, centred 28 mm right of the centreline | derived [3j], [S8] |
| Camera | CAM-1 35 x 35 x 73 mm, axis at z 660, lens front 77.9 ahead of the front axle | stated [S12], [S8] |
| Top | z 700 | stated [S1] |

**Departure from the original.** The original's mast tube measures about 58 mm square [3j]. The replica's extrusion is 40 mm, so the
visible column is slimmer below the 58 mm printed neck. A 60 x 60 extrusion would match, but at about 4.17 kg/m it would weigh 0.93 kg
(0.52 kg more) and the mass margin would shrink to about 0.1 kg; a 40 x 60 would be a compromise (not looked up). The extrusion's end is
tapped (M8) to take the neck's base plate; its slots carry the camera and servo cables, and the centre bore can pass a connector lead.

**End plate (owner's choice, 2026-11-08).** The extrusion's top end is closed by a 40 x 40 x 6 mm aluminium plate (23 g) held by one countersunk M10 x 16 screw (about 13 g, ISO 10642 head 20 mm across and
5.5 deep, ASSUMPTION: remembered figures, not looked up) into the tapped centre bore. The bore is taken as 8.5 mm, the M10 tap drill; the real HFS8-4040 bore is not confirmed. The extrusion is 6 mm shorter (top z 591),
so the stack top stays at z 597 and the tilt sweep is unchanged (clear to 90 degrees either way, 0 mm3). A catalogue metal cap was looked for: MISUMI's standard 8-series caps are polyamide, and a zinc alloy cap
(LCECA8-4040-B class, Economy Series) was found without dimensions, so the plate was chosen instead. The plate is machined, not bought; the slots stay open at the end beside it, which leaves the cable path. Mass +0.025 kg (replica 9.58 kg).

The original's mast is additively manufactured ULTEM 1010 with titanium and aluminium parts [S19]; the replica's neck, arm and head are printed
(material not chosen).

## Actuation and the head's parts (2026-11-07)

(Superseded by the built head below.) The head was no longer solid boxes: `hardware/mast/head.py` builds the neck, C-arm, camera housing and camera tube as **2 mm printed shells** (ASSUMPTION: PETG, solid
walls) with real parts inside. The outer sizes still follow the CAD figures (3j).

- **Pan servo (vertical axis, now in the base, see above; its description here applies):** a Feetech STS3215-class servo modelled from the Waveshare ST3215 2D drawing (2022-06-08) and its STEP model: body
  45.22 x 24.72 x 32 mm, output shaft 10.11 mm from one end of the long side, a 19.2 mm horn disc at each end, 37.25 mm overall along the shaft. The Waveshare part is the same
  size as the 45.2 x 24.7 x 35 mm STS3215 of the retailers and the Feetech datasheet; the equivalence is assumed, and the Feetech datasheet read has no drawing. The shaft is on
  the mast axis and the long side points +y. It stands on the housing floor (the earlier neck position is replaced). The horn hole pattern (a 14 mm pattern on the drawing) and the
  mounting ears are not modelled, and the compliant coupling between the horn and the coupling disc is not designed.
- **Tilt servo (horizontal axis, in the C-arm):** the same servo, shaft along y at z 660, body below the shaft, centred in the arm (y 28.9 to 66.1 in a 27 to 68 cavity).
- **Camera:** a Raspberry Pi Camera Module 3 (standard lens) modelled from the product brief p. 4 (PCB 25 x 23.862 x 1.12, four 2.2 mm holes, 10.8 mm square lens block, 11.3 mm
  total, lens centre 12.5 mm from the side and 14.4 mm from the bottom edge) inside the printed 35 x 35 x 73 mm CAM-1 tube [S12], its lens against a 12 mm aperture in the front wall.
  The FPC connector block is ASSUMPTION. The standard lens (75 degrees) is closer to the original's 80 degrees [S12] than the wide one (120).
- **Wires:** from the head down the extrusion's slots; the cable path, strain relief and the connector at the lid are not designed.

## CAD checks

- Top at 700 (stated); camera axis 660; lens front 214.4 (front axle at 136.5 + 77.9), which is 24 mm ahead of the body's front end (190).
- The base plate lies wholly on the deck plate (5776 of 5776 mm2) and does not touch the body or the cells.
- **Fit:** both servos and the camera module lie wholly inside their shells; no part of the head clashes with another.
- **Pan sweep, plus or minus 180 degrees:** the whole turning mast (spindle, extrusion, neck, arm, head) clears the base plate, housing, servo and bearings (0 mm3 at every 30 degree step).
- **(Superseded by the built head below, which tilts 90 degrees.) Tilt sweep of the printed-shell head: it fails.** With the head as designed, the camera tube touches the housing after **5 degrees** of tilt in either direction, and the whole head tilting as one unit touches
  the neck after 5 degrees too. The original tilts plus or minus 75 degrees [S19]. The cause is the stated geometry: the head occupies z 621 to 700 about the camera axis (z 660), so
  its lower corners sweep down to about z 610 against the neck top at 621, over the part of the neck (y -29 to 8) that lies under the head. **This needs a design decision;** the options
  are in the Open list below.

## Loads

With catalogue and CAD masses (extrusion 0.31 kg and base plate 0.05 kg; die-cast pan box 0.347 kg; spindle, flange, disc and bearing tower 0.12 kg; bearings 0.05 kg; bracket 0.069 kg; die-cast camera box 0.162 kg, printed hat and lens parts and the disk (0.015 kg, ASSUMPTION); camera body stand-in 0.010 kg (ASSUMPTION); two servos 0.11 kg; hardware 0.05 kg;
total 1.37 kg) the centre of mass is 146 mm above the deck. A sideways acceleration of 1 g (a tipping rover) puts about **1.96 N.m** on the base joint; 0.46 N.m on a 20 degree
slope. The extrusion is a stiff column (40 x 40 section); the joint at the plate is the weak point and no stress check has been done.

## Open

- **(Superseded, see the built head below.) Tilt range.** The printed-shell head cannot tilt plus or minus 75 degrees as modelled. Options (not chosen): (a) tilt only a small barrel or the lens inside a housing with a large front opening, which needs a different mechanism from a servo on the tube; (b) cut the tilt range to what fits (about 5 degrees now; a few tens of degrees if the housing's lower corners are rounded off and the neck narrowed under it, not worked out); (c) move the neck's footprint so it does not lie under the housing (the pan axis then moves off the mast centre line); (d) accept a tilt range far below the original's and note it. The original's actual head mechanism is not known from the sources read.

- Servos and camera module are candidates only (`electronics-spec.md`), none bought.
- The wires from the head down the extrusion's slots and into the body: where they enter the deck is reserved in
  `interior-spec.md` (a 15 x 40 x 30 mm zone under the base), but the entry is not designed.
- The plate is held by 4 M4 bolts through the deck into two frame rails (`frame-spec.md`); the bolts themselves, how the plate fixes to the
  extrusion (corner brackets or end-tapped screws) and the joint's strength are not modelled.
- The pan servo is in the base; the tilt servo sits in the arm; the extrusion has no cavity for them.
- Stowing: deferred. The stowed height limit (120 mm above the deck [S19]) is not met by this mast.

## Built head (2026-11-08): bent sheet bracket, `hardware/mast/headb.py`

**This supersedes the printed-shell head described above** (`head.py`: neck, C-arm, camera housing, camera tube, and the 5 degree tilt limit; `head.py` is kept for its servo and camera models). The head is now in `mast.py`
and the assembly render; `hardware/mast/head_concept.py` renders it alone to `docs/images/head-concept.png`. History: v3 (printed arm on an adapter plate, commit `2abb639`), then the owner's sheet-metal sketches
(2026-11-08) gave the bracket. Owner's rule (2026-11-07): keep what gives the original's silhouette and costs nothing, otherwise design for our parts.

- **Bracket (owner's simplified redesign, 2026-11-08, from `mast_simplified_in_situ.step`; outline traced by the owner from the original's front view [S18] Fig. 1):** a 2 mm aluminium **web**, 40 mm wide, z 545 to 690, lying flat on the extrusion's
  +y face (y 20 to 22) with three Ø6.8 holes (z 555, 569 and 583; the first two are the owner's, the third was added with the taller extrusion) for M6 into the centre slot of that face, and a 2 mm **flange** along each side edge (x +-18 to +-20 from the mast axis) standing out to y 54: a point at the extrusion at z 545, a slant to full depth by
  z 566, vertical to z 635, then a slant in to y 36 at the top (z 690). It reaches 93 mm above the extrusion top (597) and carries the head; nothing straddles the extrusion. The tilt servo (STS3215, y 19.5 to 56.7) sits between the flanges against the web, its
  horn through a Ø19.2 hole at z 660, to the disk. Mass 0.070 kg. **The extrusion was raised from 577 to 597** (2026-11-08, on the owner's suggestion) to give the web 52 mm of bolted contact instead of 32: swept by the tilting camera box, contact with the extrusion starts at 65 degrees of tilt with the top at 605, so 597 keeps a margin (clear to 90 degrees both ways, checked in `mast.py`). The original's tube tops out at 577 [3j]; the extra 20 mm is hidden behind the bracket's web from the side but shows in the front view above the original's neck line. **Overlaid on the original's front view the outline follows the original's arm (outer edge, diagonal shoulder, top)**; the flat blank is simply a plate with two edge flanges, so it
  is one bent part (two bends along the long edges, no bends across the flanges). The earlier attempts (flanges running round the bends; mitred flanges; S-shaped plates) were my misreadings or an unmakeable blank and are replaced. Camera lateral
  position: in this version y -30.5 (the sourced figure is 28 right of the centreline [S8]); the disk is 20 mm long (y -0.5 to 19.5).
- **Camera unit** (tilts as one; positions measured against the original's Fig. 1, `original-dimensions.md` 3m): a hollow printed disk (below), a **die-cast aluminium box, Takachi AL060605** (IP65, 64 x 58 x 46 mm, 162 g, gasketed, grey, M4 cover screws on 52 x 46 mm; drawing AL060605 (2025): walls 3.7,
  cavity 56.6 x 50.6, cover cap 9 deep; stated) with the cover at the front (as the cover screws are on the front of the original's camera box), 64 mm wide across y, 58 mm tall, 46 deep, centred on the tilt axis; **the Raspberry Pi HQ camera with a 4 mm CS lens** (below) in it,
  a printed slotted baffle ring and a black hood with a square window on the front, and a flat round hat (an aluminium ground-plane disc and a GNSS patch, Ø70 x 1.5 mm and 35 x 35 x 4 mm, to z 701.5) on top. The lens stands 31 mm out of the cover. **How cubic:** 64 x 58 x 46 (smallest over largest 0.72); the earlier TD6-6-4 was 60 x 60 x 35 (0.58); the original's box is
  about 57 wide x 56 tall x 59 deep (from Fig. 1, by eye). The AL series' smallest footprint is 64 x 58, so no AL model is closer to the original's 57 mm square; the AL080807 (80 x 75 x 70, 0.88) is more cubic but 40 percent wider than the original. **Position:** camera axis and tilt axis at **z 667**
  (lens centre and the original's motor disc centre both measure z 667 to 668 in the front view; the side view agrees; [S12] states 660 and an earlier side-view reading gave 664: the owner asked for the closest match to the original), camera at y -28 [S8], so the box edge is at y +4 and the disk fills the 15.5 mm from there to the web.
  **Hood:** the window is square to the box (it was turned 8 degrees, from the flight photo [S5] Fig. 8; the CAD front view [S18] shows it square, and the owner asked for it straightened).
- **Hat is a real antenna (decided 2026-11-08, owner chose option 2):** the original's plate is its S-band patch antenna (`original-dimensions.md` 3m), on the gimbal atop the camera box. The replica's hat is a **GNSS (GPS L1) patch** on an **aluminium ground-plane disc**: the disc is Ø70 x 1.5 mm sheet, bonded to the box top (z 696 to 697.5), and a 35 x 35 x 4 mm ceramic patch (passive, of the Taoglas HP5354.A class, retailer listing; mass 15 g is an assumption) sits on it, top at **z 701.5, 1.5 mm over the stated 700**. It feeds a coax that follows the camera ribbon through the disk's cable spool. A GNSS receiver module (10 g allowance, not placed) sits in the body. The patch tilts with the camera, so GPS reception is best with the camera level; with the camera tilted down 90 degrees the patch faces forward. Other ideas not taken: a 2.4 GHz circularly polarized ceramic patch (Taoglas WPC.25A, 25 x 25 x 4 mm, 6 dBi) or a hand-built air-spaced aluminium patch (the paper models 65 mm across over a 0.6 mm gap, 2.42 GHz); ready-made active GNSS patches are too tall (Taoglas ADFGP.60A: Ø80 x 19 mm).
- **2.4 GHz antenna, on the body (decided 2026-11-08):** after the original's sleeve dipole (the rover-to-lander antenna, 2.23 dBi; 55.7 mm long, 159.5 mm with its tube in the paper's model), vertical on the top face of the body **290 mm behind the mast** (x -129, y +58 by my reading of the figure, unverified), `hardware/body/antenna.py`. Off the shelf, at the paper's length: the **AIR802 ANRD2403-RSP** (3 dBi, 13.5 x 158 mm, black, RP-SMA plug; retailer listing) is modelled, on a 6 mm aluminium block, 158 mm tall (top at z 512); the 5 dBi ANRD2405-RPSMA (157.4 mm) is the alternative. The listings do not say whether the plug is straight or angled, nor give a mass (15 g assumed). Shorter ones: Taoglas GW.20.A151W (89.5 mm, white), Adafruit 944 swivel (100 mm, 9.92 g), LSR (105 mm, black). The Pi Zero 2 W has no antenna connector, so a USB WiFi adapter with an RP-SMA connector (10 g allowance) feeds it. This gives the replica a real 2.4 GHz link on an antenna in the original's place.
- **Lens (off the shelf, 2026-11-08):** the original's lens is a 3D Plus CASPEX 3DCM739 camera with a Lambda-X 7.8 mm, f/8, 82 x 82 degree optic [S12], which cannot be bought. The replica uses the **Raspberry Pi High Quality Camera (CS mount, Sony IMX477, 12.3 MP, 7.9 mm diagonal sensor)** and a **4 mm CS-mount lens**:
  the HQ camera is a 38 x 38 mm board (four Ø2.5 holes 30 x 30 apart, a Ø36 focus-ring mount 10.35 mm deep, the board 1.4 mm, the FPC connector 5.71 mm tall at the board's bottom edge and standing 2.75 mm behind the board, the ribbon 13.97 wide leaving downward; Raspberry Pi product brief RP-008202-DS-1, p. 4; stated; corrected 2026-11-08: the model had 5.71 mm as the depth behind the board), close to the CASPEX's 35 x 35 footprint, and it takes any CS or C lens, so the lens can be changed later (`electronics-spec.md`).
  The 4 mm lens (a generic 5 MP, 1/2", f/1.2, fixed iris, manual focus, 80 degrees horizontal, 30 x 42 mm, 49 g; one retailer's listing, no maker named, so treat the figures as unverified) gives about 76 degrees horizontal on the IMX477 (arithmetic from the sensor width), near the original's 82. Other options: the official 6 mm lens (63 degrees, 30 x 34 mm, 53 g, stated by retailers),
  a 3.2 mm CS lens (113 to 120 degrees), or the Camera Module 3 Wide (102 x 67 degrees, 25 x 24 mm board, 4 g), which is 0.09 kg lighter but has no changeable lens and a board too large to sit behind the baffle ring. The HQ camera (about 50 g by a retailer listing, CS variant assumed) and the lens (49 g) add 0.09 kg over the earlier 10 g stand-in. A Pi Zero 2 W needs a Zero camera cable (the HQ camera's is the 15-pin one).
  In the model the lens front is 8 mm behind the hood face, the board and mount sit in the box (board front face at x 154), and the lens barrel passes through the Ø35 cover hole and a Ø31.2 bore in the baffle ring; the hood window is 8 mm in front of the glass, so it does not vignette a 76 degree field.
- **Tilt servo mounting (2026-11-08):** the STS3215 (Waveshare ST3215 drawing, 2022: 45.22 x 24.72 x 32 mm body, 37.25 over the horns) has **four holes on each end face, 25.4 mm apart along the long side and 20.5 across**, at 7.4 and 32.8 mm from the shaft along the body (read from the drawing, scale 5.1 px/mm: plus or minus 0.3 mm), and the output
  horn is a Ø19.2 disc with four holes on a Ø14 circle and a centre screw. The thread is not stated (retailers say M3; unverified). The servo stands against the outer (+y) face of the bracket web with its horn through the Ø19.2 pass-through hole, held by **four M3 screws from the web's inner face** into its front-face holes (the web has four Ø3.4 holes at x +-10.25, z 659.6 and 634.2); the screw heads lie in the 0.5 to 2.5 mm gap between the web and the disk, where the disk's annular recess clears them (use low-profile pan heads, not countersunk, which a 2 mm sheet
  cannot take). The servo sits 5.6 mm clear of each fin, and its rear end (y 56.7) is free. Load: the servo's stall torque is 1.91 N.m (`electronics-spec.md`), so the four screws on a roughly 16 mm radius see about 30 N each at stall; the camera unit's own weight moment is about 0.1 N.m. The web's bearing and the screw threads in the servo's case are not checked.
- **Camera link (decided 2026-11-08, owner chose option A; revised 2026-11-08: extender changed to the Arducam B0091 CSI-to-HDMI kit, its Tx board moved INSIDE the camera box):** the camera's video goes over the extender's HDMI cord (CSI-2 over an ordinary HDMI cable, reported 3 to 5 m, up to 10 m with a good cable; the kit sells two boards and two 60 mm 15-pin ribbons, no cord). The **Tx board is inside the die-cast camera box** behind the HQ board, the Rx board hangs under the deck beside the Pi, and the cord runs between them in a loose loop. **Board sizes (derived from the manufacturer's 3D drawing UC-392(B0091).STEP, read 2026-11-08; the file is in the private repo and not copied):** PCB 25.2 x 27.83 x 1.67 mm with **four Ø2 mounting holes** (M2; Arducam datasheet Rev 1.0, Mar 2017, drawing p. 3: 21.0 across x 12.5 apart, R 1.0; the STEP gives centres 2.0 from the sides and 13.2 and 25.7 from the mouth edge; the kit ships four M2 screws and spacers; an earlier version of this note said "no holes" because I truncated a listing of the STEP's holes); HDMI receptacle 15 x 12 x 6.08 above the PCB top (mouth 0.45 mm past the board edge); 15-pin FPC connector 21.3 x 7.6 x 2.65 on the top face at the far end; the **3.5 mm audio (headphone) jack**, 12 x 6 x 4.87, and a small 2 x 5 x 5 stub on the underside (datasheet: a spare for audio or GPIO signals, unused here). **Decided 2026-11-08 (owner): the jack is desoldered from both boards**, so neither it nor the stub is modelled; the receptacle's pins stand 0.53 mm below the PCB. **In the box (`headb.tx_board`):** the board plane is perpendicular to the camera axis, the PCB on **four 2 mm M2 standoffs** from the box's inner back wall (ASSUMPTION, see the fixing note below), the pin tips 1.47 mm off the wall, the receptacle toward the camera, the mouth facing the -y wall, the board 25.2 across z centred on the camera axis. The 9.75 mm stack (2 standoff, 1.67 PCB, 6.08 receptacle) fits the 11.25 mm behind the HQ board **without moving the camera** (`CAM_SHIFT` is 0; the lens recess stays 8 mm; with the jack kept it needed 5.5 mm standoffs and a 2.5 mm shift): gaps 1.50 mm from the receptacle top to the HQ board, 4.83 mm from the Tx PCB to the HQ rear connector block (which stands only 2.75 mm behind the board), 1.5 mm from the board's far end to the heads of the disk screws (all measured in `mast.py`, 0 mm3 overlap with the box, camera body, lens, baffle and hood). **The cord's plug stays inside:** a slim HDMI plug head on the receptacle. **Named cord (found 2026-11-08, datasheets read):** the **Lindy CROMO Slim High Speed HDMI Cable with Ethernet, 1 m, part 41671** (datasheet, 2 pages, 2021, a copy in `maha-rover-private/datasheets/lindy-hdmi-cable-slim-1m-datablad-1.pdf`, read 2026-11-08: 4 twisted pairs plus stranded 36 AWG conductors with foil and braid, full HEC, ARC and CEC support so all 19 pins are used, **maximum connector size 16.2 x 13.8 x 6.8 mm**; lengths 0.5 to 4.5 m, so 1 m is the first that covers the 659 mm loop. The 1 m sheet gives **no jacket diameter, bend radius or pinout**; the Ø3.2 mm jacket, 32 mm minimum bend radius and a 19 x 16 x 7 mm head (21 mm with a chip) come from the 0.5 m sheet 41670 and retailer listings, so they are not stated for the 1 m cord). Alternatives with datasheets: **C2G Plus Series 41363 (0.9 m)** (Legrand AV 240104 Rev C: 19-pin male solder-type plugs, 36 AWG, Ø3.6, minimum bend 25.4, foil shield; its plug hood is 25 long, 8.2 thick and 18.6 wide, tapering to Ø7.6, which is **1.2 mm too long** for the 23.8 mm room unless the Tx board moves 1.2 mm toward +y, which the 1.5 mm margin to the disk's screw heads allows only just) and **StarTech HDMI21-CBL-SLIM-1M** (Ø4.0, 34 AWG, 17 mm wide x 9.2 mm thick overall, 0.1 mm over the thickness limit below). The model's plug envelope is **16.2 wide x 6.8 thick x 21 long** (the Lindy). The plug's axis is at x 148.1 (6.7 mm in front of the box's inner back wall), and the HQ board's back face at x 152.65 limits its thickness to 2 x (152.65 - 148.1) = **9.1 mm** (7.1 mm with 3 mm standoffs, which is why the standoffs are 2 mm); a standard moulded boot, 10 to 14 mm thick, will not fit. **23.8 mm** of room from the mouth to the -y wall (an earlier version of this note said 28 mm, which was wrong). The cord leaves through a **PG7 cable gland** (thread Ø12.5, for 3 to 6.5 mm cords, IP68 class; a catalogue part, ASSUMPTION, none chosen, about 5 g) in a **Ø12.5 hole in the -y wall** at x 148.1, z 667 (the model has a hex body of 15 across corners and 12 mm outside the wall, `headb.gland`; it clears the bracket in every tilt position). This replaces the aluminium pod, the 20 x 3 mm ribbon slot and the RJ45 plug (13.5 x 12 mm). The round cord **hangs loose** (`headb.camera_link_cable`, Ø5.5 mm sweep) from the gland, swings out on the -y side and drops to the deck gland hole at x 112, y -36 over the Rx jack: as the original's harness does in the owner's photographs of the flight model, not through the mast. Length (`cable_route.py`): 322 mm gland to deck gland, 8 mm to the Rx jack, plus 128 mm of pan slack (the gland circles the axis at about 64 mm), 100 mm of tilt slack and 40 mm of strain relief: 599 mm, 659 mm with a 10 percent allowance. The same loop style carries the GNSS coax and the tilt servo's wires. Mass: Tx 0.010 (assumed), Rx 0.010 (assumed), gland 0.005 (assumed), thin 1 m HDMI cord 0.040 (assumed): about the same as the pod version. **Open items, worked 2026-11-08.** (1) *HQ ribbon route:* the HQ's connector is at the board's bottom edge, 2.75 mm behind the board, ribbon leaving downward; the Tx board's FPC connector is on its camera-side face at the far end (y -16.4 to -8.8, x to 148.7). The straight distance between them is about 25 mm and a folded S route 40 to 50 mm, against 80 mm ribbons (datasheet; retailers say 60 mm); the 1.5 mm gap above the receptacle and 3.9 mm above the Tx connector take a 0.3 mm ribbon. Feasible by length and space, **not drawn**: the contact direction of the Tx connector and the ribbon's bend radius in the 6.3 mm under the HQ board (cavity floor at z 641.7, board edge at 648) need a physical test. (2) *Standoff fixing:* the wall is 3.7 mm; use M2 male-female standoffs into blind tapped holes 2.5 mm deep (1.2 mm left to the outside, so the IP65 face stays closed; drill pilot depth 2.5 plus the tip, not through). The load is trivial (board 10 g, 0.3 N at 3 g). Cast bosses and draft are not modelled and the real inner wall may not be flat. (3) *Gland and sealing:* a PG7 gland (above) with its gasket, plus the box's own gasket (the AL060605 is gasketed); the thread hole in a 3.7 mm cast wall needs a flat spot-face for the gland's sealing washer (outer face of the -y wall is flat). Not designed in detail. (4) *Plug:* the Lindy 41671 is the named cord (above); its head fits, measured here from its datasheet, not from a sample. (5) *Heat (estimate, ASSUMPTION):* the box's outer area is about 0.0186 m2; natural convection and radiation from a painted or anodised surface give about 10 W per m2 per K, so about 0.19 W per K; if the camera and extender dissipate 1.5 W (the HQ camera's draw was not looked up; the extender's is not given in its datasheet) the box runs about 8 K above ambient in shade, more in sun. Not a limit for the electronics, not checked against the sensor's rating. **Compatibility (researched 2026-11-08; retailer and vendor pages, nothing tested):** the vendor lists the Raspberry Pi HQ camera (IMX477) as supported for the B0091 (Arducam product page; Core Electronics lists the Camera Module 3, HQ, V1 and V2 and says no extra software is needed), and the Zero and Zero 2 W among the supported boards. The old Rev 1.0 datasheet (2017) lists only the V1 and V2, so it predates this. The pack contents differ between sellers: Core Electronics lists two 60 mm 15-pin ribbons plus two 22-way (0.5 mm) to 15-way (1 mm) adapter cables, Arducam's listing two 73 mm 22-pin cables, the 2017 datasheet two 80 mm 15-pin ribbons; **buy a pack that includes the 22-way cable for the Pi Zero 2 W and check it before ordering (no ordering now)**. **Cord constraint:** the Core Electronics page warns the product 'relies on pins that are not present on all HDMI cables, so if you have issues, try a different cable', and that 3 to 5 m needs a good cable; so the cord must be a **full 19-wire straight-through HDMI cable**, not a cord that drops the spare pins. Slim cords (3.5 to 4.2 mm) are made, but whether a given one passes every pin is not shown in the listings: choose one that states all 19 conductors. **Still open:** the real HQ connector width (16 mm is an assumption), the Lindy cord's real head length and that it passes every HDMI pin as the B0091 needs (its datasheet gives conductors, not a pinout), the Pi Zero 2 W with the HQ camera through the extender (untested, listed as supported), and the loose loop's behaviour.
- **Disk, its function (resolved 2026-11-08):** a hollow **turned aluminium** shell (6061 bar, 4 mm side wall, 2 mm end wall, 40 mm across, y 4 to 19.5, 0.021 kg; it was printed at 0.010 kg until the owner asked for metal; made on a lathe and a drill, with the M3 threads tapped straight into the metal and no inserts, the rim slot milled and its edges rounded and deburred for the ribbon) that does two jobs. (1) **Coupling:** it turns with the servo horn and carries the camera box: a Ø19.2 boss at the web end sits on the horn (four screws on the Ø14 pattern and a centre screw), and the open end is bolted to the box's +y wall by four M3 on a Ø36 circle (clearance holes in the 3.7 mm cast wall, M3 threads tapped in the shell's ring; assembly order: disk on the horn first, then the box on the disk).
  (2) **Cable spool:** the camera-link cable arrives along the box's underside, passes through an 18 mm slot in the rim at the bottom (it no longer goes through the box wall), loops round the rim and is clamped to the bracket fin's edge; with a +-90 degree tilt the length changes by about 31 mm each way, so about 70 mm of slack is needed. It carries no sensor (the servo has its own 12-bit magnetic encoder, retailer listing) and no tilt hard stop is designed. This replaces the earlier "encoder or mounting, unknown" disk; in the original the round motor of that size sits there (about 56 mm across and 20.7 mm thick, `original-dimensions.md` 3m), which ours does not copy. Section view: `docs/images/disk-section.png`.
- **Checks (`mast.py`):** no overlaps among bracket, extrusion, servo, disk and enclosure; the pan sweep of the whole turning mast clears the base (0 mm3 at every 30 degrees); **the camera stack clears the box (0 mm3) and the camera unit tilts plus or minus 90
  degrees without touching the bracket, tilt servo or extrusion** (the original tilts 75 degrees [S19]).
- **Not designed:** drilling the box for the hat, the lens hole in the cover (Ø35 in the model), whether the HQ board and its Ø36 mount clear the cast screw posts (modelled as round 11 mm posts; the drawing leaves only 31.7 and 32.8 mm between them; the model clears them by 2.5 mm), how the lens is locked after focusing, servo horn to disk attachment, cable route through the bracket and down the extrusion slots, the open top of the extrusion under the bend, a hard stop for tilt, bend reliefs and the flat pattern,
  bracket stiffness (the web window is 36 mm of its 44 mm width), whether the printed enclosure is split for assembly, the octagonal hollow mast and lightening slots (not copied) and what the pink surface in the flight photo is (not known).
