jacob-rn-wallace/maha-rover/docs/replica-mass.md

# Replica mass and centre of mass (first pass)

Generated by `hardware/mass/replica.py` from the CAD parts (re-run it to refresh). Frame as in `hardware/body/body.py`: X forward, Z up
from the ground line (the rim line). Densities: aluminium 2.70 g/cm3 and steel 7.85 g/cm3 (standard values), printed PETG 1.27 g/cm3
(typical, not verified). Frame members use the catalogue 0.50 kg/m; the mast extrusion 1.86 kg/m. Allowances (the differential's gears, wiring and fasteners, boards, solar
pieces) are marked ASSUMPTION in the script: they are not designed. The goal is the original's 10 kg, with a ceiling of 10.5 kg
(owner, 2026-11-08: the original uses ultra-light materials, so no part is weakened or made non-metal just to reach 10; panel thinning, 0.48 kg, is not applied).

```
group                                  kg   share      x      z
panels                               2.36     25%      0    246
T-slot frame                         1.69     18%      0    211
mast, head and camera                1.47     15%    162    505
wheels                               0.94     10%     -0    100
link plates, sleeves, shafts         0.88      9%     -0    126
drive motors                         0.78      8%      0    100
electronics                          0.42      4%    -47    165
harness and fasteners                0.40      4%      0    190
differential                         0.30      3%      0    146
pivot standoffs                      0.12      1%      0    240
solar pieces                         0.09      1%      0    255
antennas and radios                  0.07      1%     58    447
terminals, diodes, fuses             0.05      1%      0    255
bushings                             0.02      0%     -0    146
TOTAL                                9.58   goal 10 kg: +0.42 kg; ceiling 10.5 kg: margin +0.92 kg

centre of mass: x 23.2, y -0.3, z 234.6 (mm, ground at the rim line)
static tip angles: nose-down 34 deg, nose-up 26 deg, sideways 47 deg  (the slope requirement is 20 deg)
  assumptions: wheels 1.07 g/cm3 solid (0.24 kg each), allowances 0.84 kg
```

## Reading the result

- **9.58 kg: 0.42 kg under the 10 kg goal, 0.92 kg under the 10.5 kg ceiling** (2026-11-08: a 40 x 40 x 6 aluminium end plate and an M10 countersunk screw on the mast extrusion, which is 6 mm shorter under it: +0.025 kg; 2026-11-08: six deck gussets, +0.09 kg; 2026-11-08: the end panels were recessed to the wheel axle line, full height, and the rail under the mast was removed, `original-dimensions.md` 3n: the floor, end panels and rails got shorter, -0.59 kg; before that 10.06 kg) (2026-11-08: the round-cable camera link, option A of `electronics-spec.md`, added 0.067 kg: Tx board in the camera box, Rx board and the 1 m cord, hanging loose like the original's harness; before it the total was 9.998 kg, with) (the GNSS board and the servo bus adapter became placed parts, 0.029 kg, in place of 0.020 kg of allowances, and the RF cables and ribbon are 0.008 kg; any camera-cable fix in `electronics-spec.md` costs more) (the GNSS patch on an aluminium hat disc, the 2.4 GHz dipole and the radio allowances added 0.05 kg; the disk in aluminium instead of print: +0.011 kg; 9.88 before the HQ camera and 4 mm lens replaced the 10 g stand-in: +0.09 kg, less 0.05 kg of printed collar and plate that went). Applied 2026-11-08 in the mass second pass (after the die-cast boxes had taken the replica to 10.50 kg): the link plates are 4 mm instead of 8 (the pivot boss grows from 12 to 16 mm so the shaft keeps its 20 mm bond; net 0.40 kg), the wheels are printed in ASA (1.07 g/cm3) instead of PETG (0.18 kg), and the mast base plate is 3 mm instead of 6 (0.05 kg). The mast column stays the 40 x 40 T-slot extrusion (a 60 x 60 x 2 tube would have saved 0.10 kg, declined so that others can mount things on the mast). The estimate is only as good as its guesses: 0.84 kg of it is allowances, the wheels are a solid printed estimate (0.24 kg each in ASA; the same CAD wheel in the original's magnesium alloy would be 0.40 kg each), and
  the differential's gears and housing are sized (0.17 kg, with 0.30 kg allowed for bushings and hardware) but its mounts are not designed. The margin is small; the levers below are the first things to cut if it vanishes.
- **The chassis is the biggest item:** panels 2.4 kg and frame 2.1 kg are 46 percent of the total, against the original's 2 kg
  structure [S26] (the original's figure excludes mobility, and does not count panels the same way).
- **Centre of mass:** x 11 mm (forward of the axle midpoint), z 205 mm. The mast is now 8 percent of the mass (0.80 kg), which moves the centre forward and up.
  Static tip angles: **nose-down 36, nose-up 31, sideways 50 degrees** against the 20 degree slope requirement: 11 degrees of margin
  for climbing, better than the original record's range (`mass-budget.md`: 22 to 28 degrees nose-up).
  These are static, on a rigid chassis; the suspension (a pivoting link plate per side) and dynamics are not covered.
- **Drive sizing:** the slope torque per wheel at 9.9 kg is 0.83 N.m, a little under the 0.84 N.m the motors were sized for.

## Levers (arithmetic on the numbers above; 2026-11-08)

**Applied** (10.50 to 9.88 kg): link plates 8 to 4 mm aluminium (0.40 kg net of the bigger boss and longer sleeves: beam estimate on the plate's section at the pivot, about 60 mm high after the bore: in-plane stress 6.5 MPa and out-of-plane 51 MPa at 3 g with a 0.8 friction side load per wheel, against 240 yield; lateral tip deflection 0.8 mm per g of side load, about 2.3 mm at 3 g, camber about 1 degree, against 0.1 mm at 8 mm; the shaft joint check in `rail_check.py` is unchanged at factor 8; not an FE check), wheel material PETG to ASA (0.18 kg), mast base plate 6 to 3 mm (0.05 kg).

**Declined:** mast column to a 60 x 60 x 2 aluminium tube (0.10 kg): the owner keeps the T-slot extrusion for future mounting on the mast.

**Remaining:**

| Lever | Saves | Notes |
|---|---|---|
| Side, end and floor panels 2 mm to 1.5 mm | about 0.48 kg | Panel stiffness unchecked (four-point stiffness is an open item) |
| Mid rails and differential cross rails | up to 0.44 kg | Only if the differential moves; they carry it |
| Wheels in nylon instead of ASA | 0.05 kg | |
| Link plates 4 mm to 3 mm | 0.11 kg | About 2.4 times the out-of-plane deflection; not recommended |
| Bracket 2 mm to 1.5 mm | 0.02 kg | |
