jacob-rn-wallace/maha-rover/docs/mass-budget.md

# Mass budget and centre-of-mass check

Generated by `hardware/mass/budget.py` (re-run it to refresh the tables). Frame as in
`hardware/body/body.py`: X forward, Z up from the ground. Masses in kg, lengths in mm.
Status tags follow `original-dimensions.md`.

## What this does and does not show

Five things about the original's mass split are published: the 10 kg total [S1], the
structure (2 kg, excluding the mobility subsystem [S26]), the mast and gimbal (1.237 kg EM,
under 1.4 kg flight [S19]) and the two cameras (210 g each [S12]). The wheel mass is the CAD
model's own 398 g at an assumed alloy density, not a source, and excludes the motors.
So **4.75 kg of the 10 kg is unallocated**: battery, electronics, the four drive motors and the
passive differential [S25], harness, any panels and thermal blankets not counted in the 2 kg,
and the other instruments. The script places that remainder at three heights inside the body,
so the result is a **range** for the centre of mass, not a value.

body envelope centroid z = 229 mm (solid wedge, deck included)

| Item | kg | Status |
|---|---|---|
| wheels x4 | 1.592 | ASSUMPTION: 398 g from wheel.py at AZ91E density; closed test wheel 1.18 kg [S4] is not the flight wheel |
| mast + gimbal | 1.237 | stated [S19]: 1.237 kg EM, < 1.4 kg flight; assumed to exclude CAM-1 |
| CAM-1 | 0.210 | stated [S12] |
| structure | 2.000 | stated [S26]: 2 kg for the mechanical structure, excluding the mobility subsystem; placed at the body envelope centroid (ASSUMPTION) |
| CAM-2 | 0.210 | stated [S12]; position: rear, axis 250 high (stated), x assumed at body rear |
| Unallocated: battery, electronics, drive motors and differential, harness, panels and MLI if not in the 2 kg, other instruments | 4.75 | (unverified): the rest of the stated 10 kg [S1] |
| **Total** | **10.00** | stated [S1] |

| Configuration | Remainder height | CoM x | CoM z | nose-down | nose-up | sideways |
|---|---|---|---|---|---|---|
| deployed | low (z=150) | 20 | 217 | 36 | 28 | 49 |
| deployed | body centroid (z=229) | 20 | 254 | 32 | 25 | 44 |
| deployed | high (z=300) | 20 | 288 | 28 | 22 | 41 |
| stowed | low (z=150) | -9 | 193 | 33 | 37 | 52 |
| stowed | body centroid (z=229) | -9 | 231 | 29 | 32 | 47 |
| stowed | high (z=300) | -9 | 264 | 26 | 29 | 43 |

Slope requirement: 20 degrees [S1][S3]. Tip angles are static, on a rigid chassis, wheels at the hub line.

## Reading the result

- Every case clears the 20 degree slope requirement for nose-down and sideways tipping.
- Nose-up (climbing) is the tightest: 22 degrees in the worst case (all unallocated mass
  high, mast deployed), a margin of about 2 degrees. With the remainder at the body centroid it is 25.
- That worst case depends on assumptions: CAM-2 at the body rear (x only is unverified), the
  mast mass at the tube midpoint, the 2 kg structure at the body centroid, and the wheel mass.
  A heavier wheel lowers the centre of mass.
- Static tip angles on a rigid chassis. The suspension is a passive differential gear with
  skid steering [S25], which couples the two sides' pitch and changes the contact geometry on a
  slope; this is not modelled. Dynamic effects are not covered either.

## What would tighten it

Battery capacity and mass, motor and gearbox mass, the flight wheel mass (asked of the thesis
advisors, see `wheel-spec.md`), and any mass breakdown from MBRSC. Each reduces the 4.75 kg
unallocated block and its height range.
