jacob-rn-wallace/maha-rover/docs/images/disk-section.png

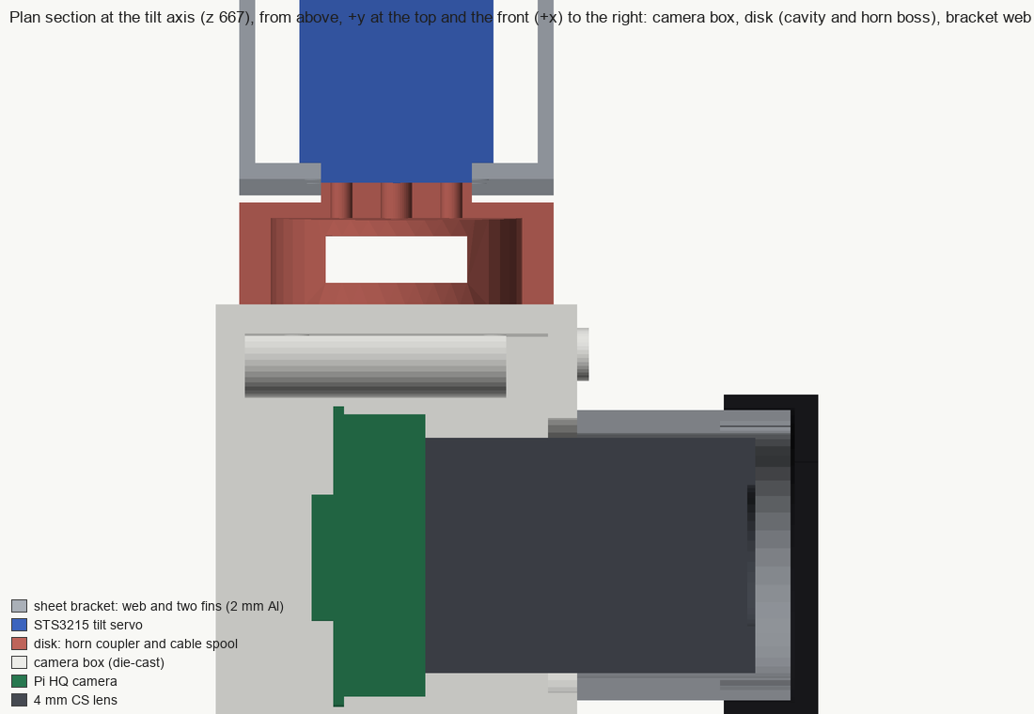
docs/images/disk-section.png
