jacob-rn-wallace/maha-rover/docs/images/head-concept.png

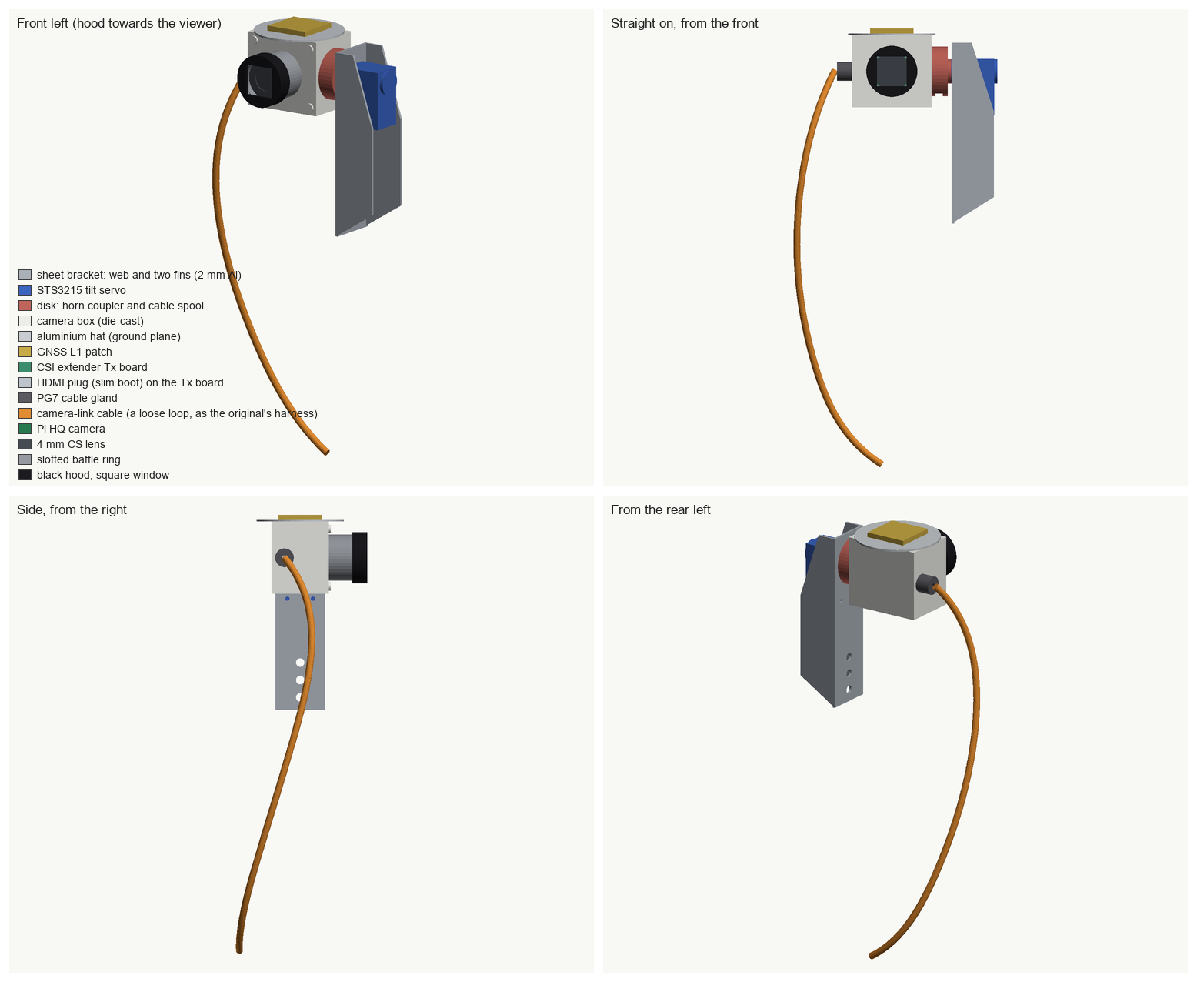
docs/images/head-concept.png
