jacob-rn-wallace/maha-rover/docs/images/sim-ui-layout.png

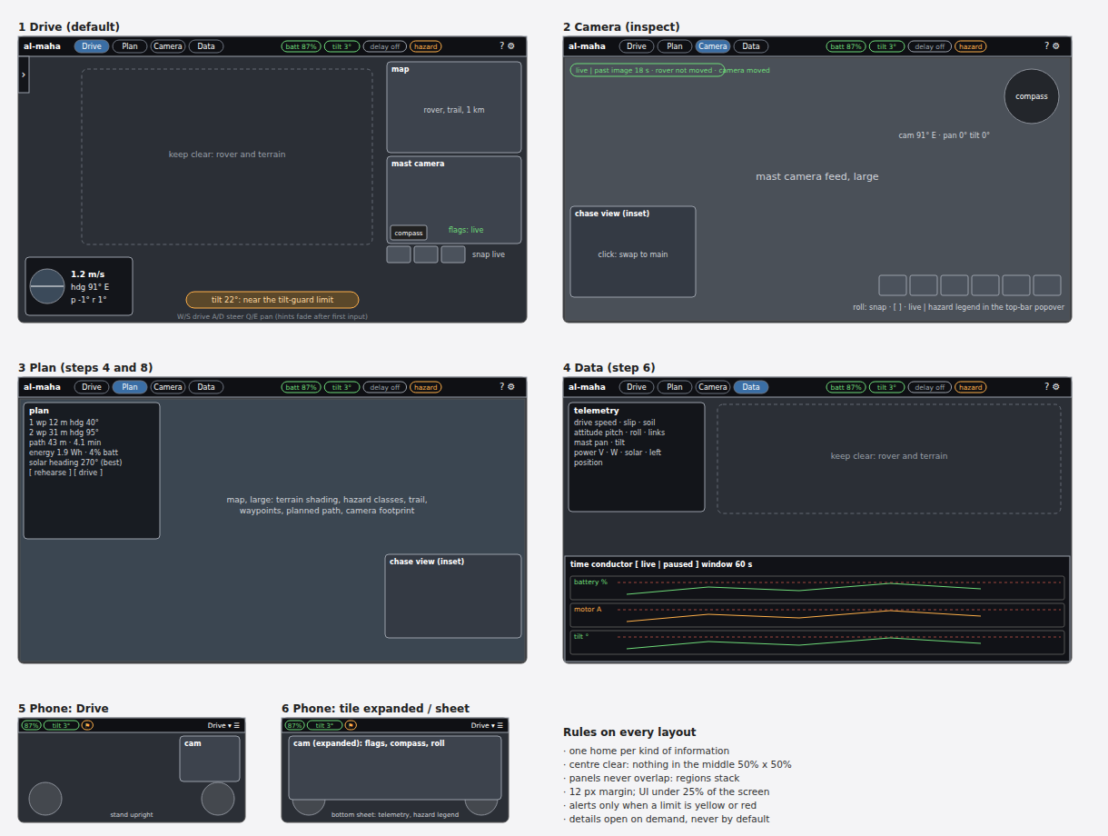
docs/images/sim-ui-layout.png
