jacob-rn-wallace/maha-rover/docs/images/solar-cell-mockups.png

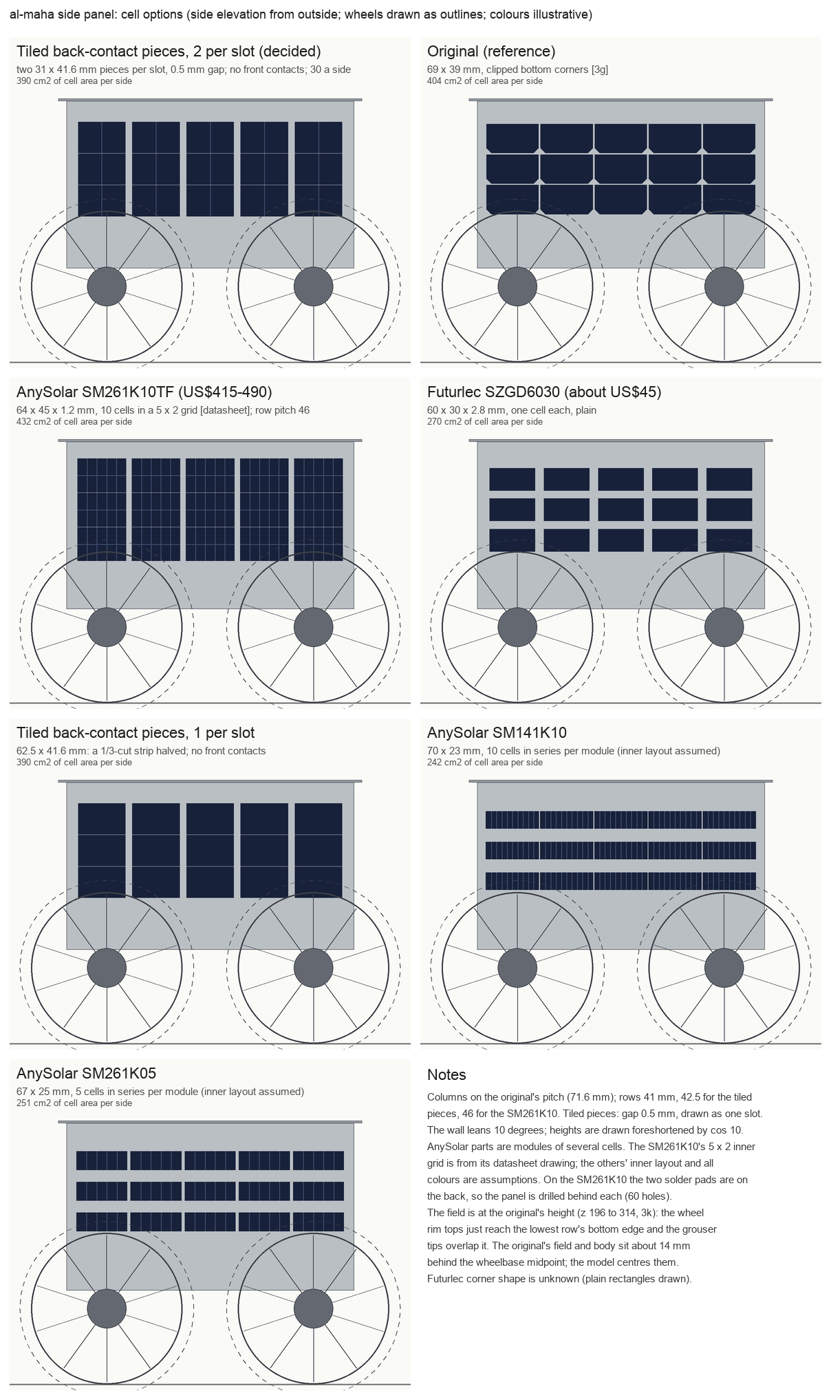
docs/images/solar-cell-mockups.png
