jacob-rn-wallace/maha-rover/graphic-design/poster/almaha-poster-trapezoid.jpg

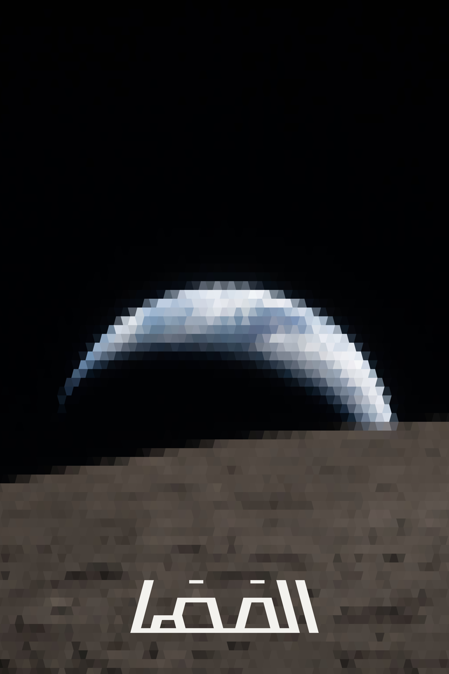
graphic-design/poster/almaha-poster-trapezoid.jpg
