jacob-rn-wallace/maha-rover/graphic-design/social-preview/almaha-social-preview.png

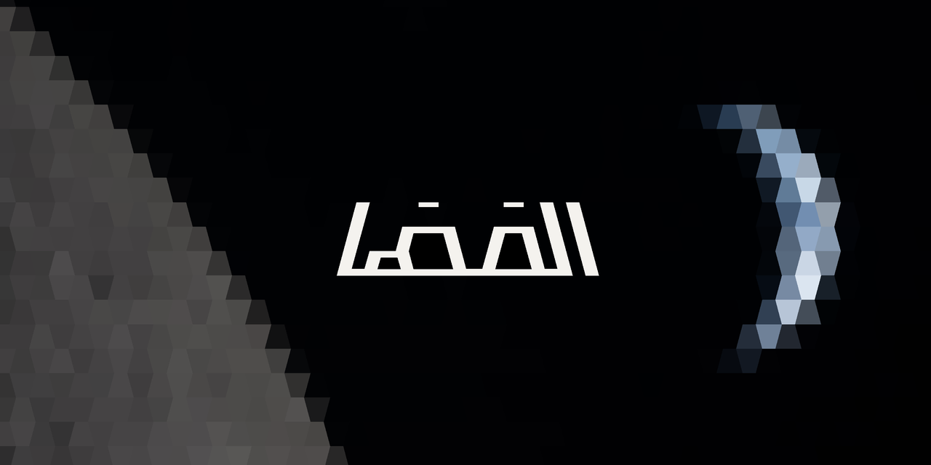
graphic-design/social-preview/almaha-social-preview.png
