jacob-rn-wallace/maha-rover/hardware/body/out/rover.step

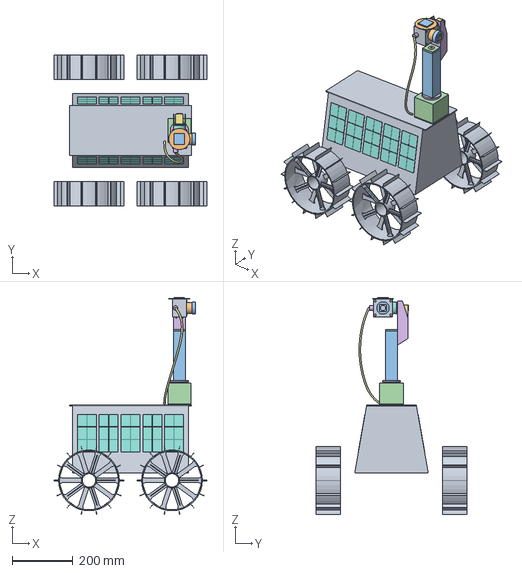
[picture p8: CAD file, 2026-11-09]
hardware/body/out/rover.step
503.0 x 495.4 x 713.7 mm
