jacob-rn-wallace/maha-rover/hardware/chassis/out/frame.step

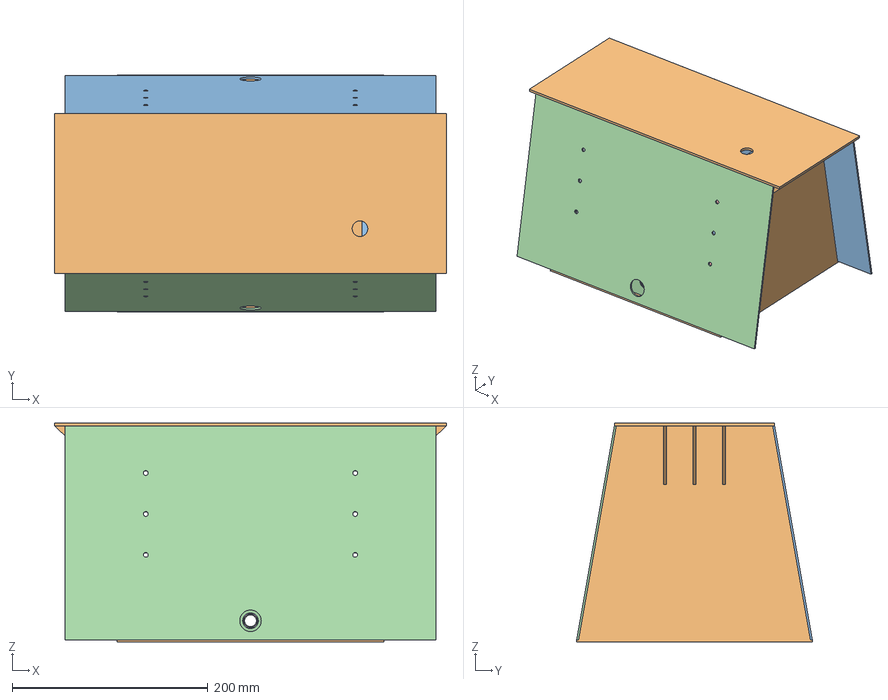
[picture p9: CAD file, 2026-11-08]
hardware/chassis/out/frame.step
401.0 x 241.9 x 224.0 mm
