jacob-rn-wallace/maha-rover/hardware/mast/out/mast.step

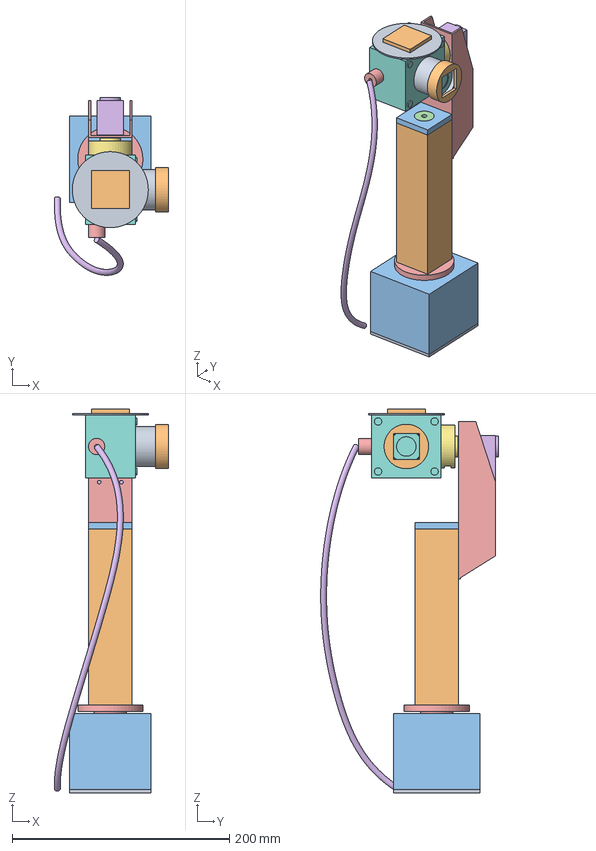
[picture p10: CAD file, 2026-11-09]
hardware/mast/out/mast.step
105.2 x 163.6 x 353.5 mm
