jacob-rn-wallace/maha-rover/hardware/suspension/link/link_plate.step

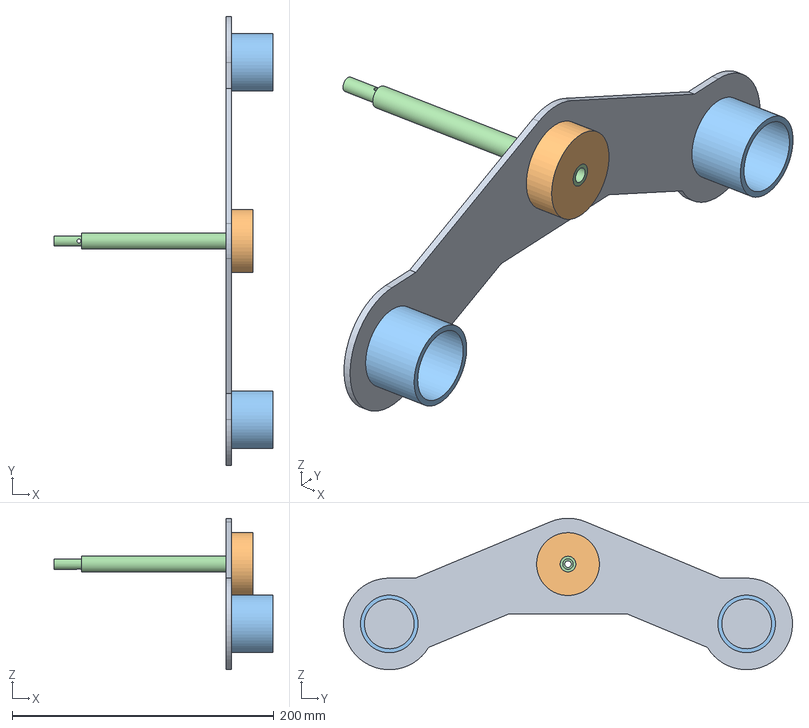
[picture p11: CAD file, 2026-11-08]
hardware/suspension/link/link_plate.step
167.2 x 343.0 x 115.6 mm
