jacob-rn-wallace/maha-rover/hardware/suspension/out/rover_drive.step

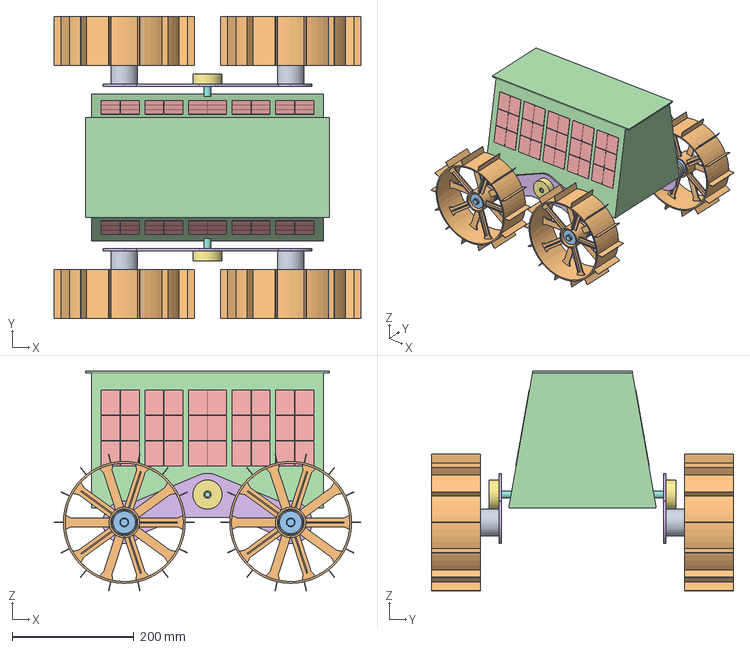
[picture p12: CAD file, 2026-11-08]
hardware/suspension/out/rover_drive.step
503.0 x 495.4 x 360.2 mm
