jacob-rn-wallace/maha-rover/hardware/wheel/out/wheel.step

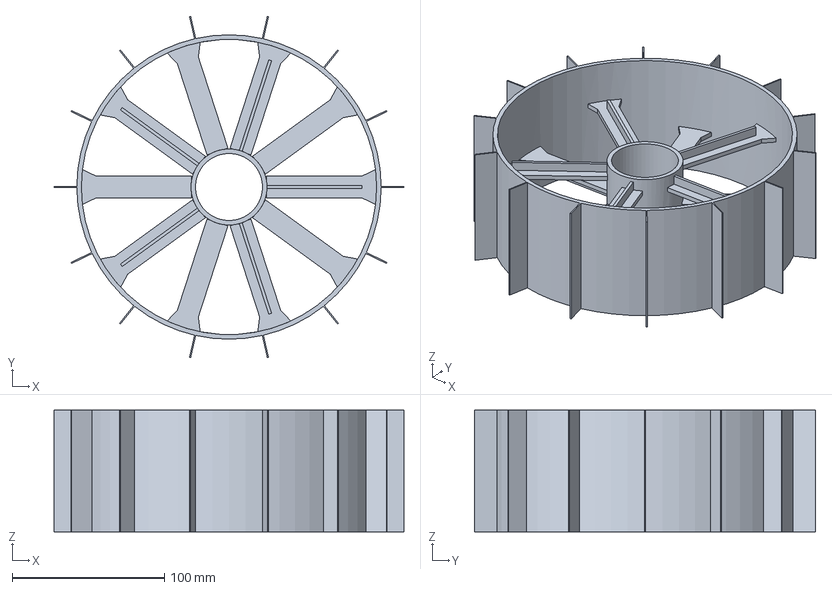
[picture p13: CAD file, 2026-11-07]
hardware/wheel/out/wheel.step
230.0 x 224.4 x 80.0 mm
