jacob-rn-wallace/maha-rover/hardware/body/out/interior.step

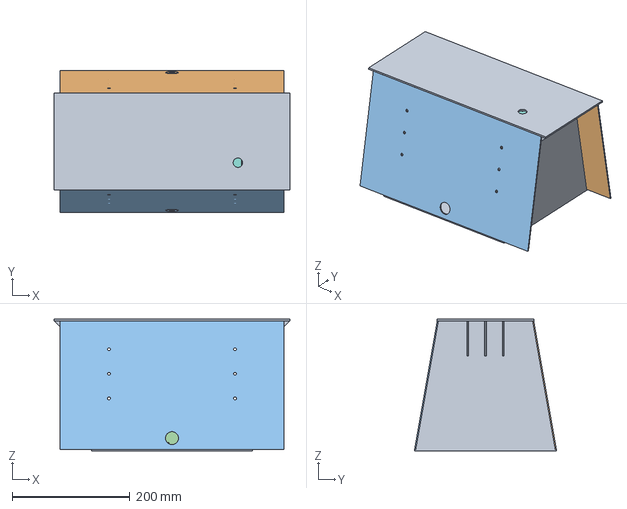
[picture p14: CAD file, 2026-11-09]
hardware/body/out/interior.step
401.0 x 241.9 x 224.0 mm
