jacob-rn-wallace/maha-rover/hardware/mast/out/mast_stowed.step

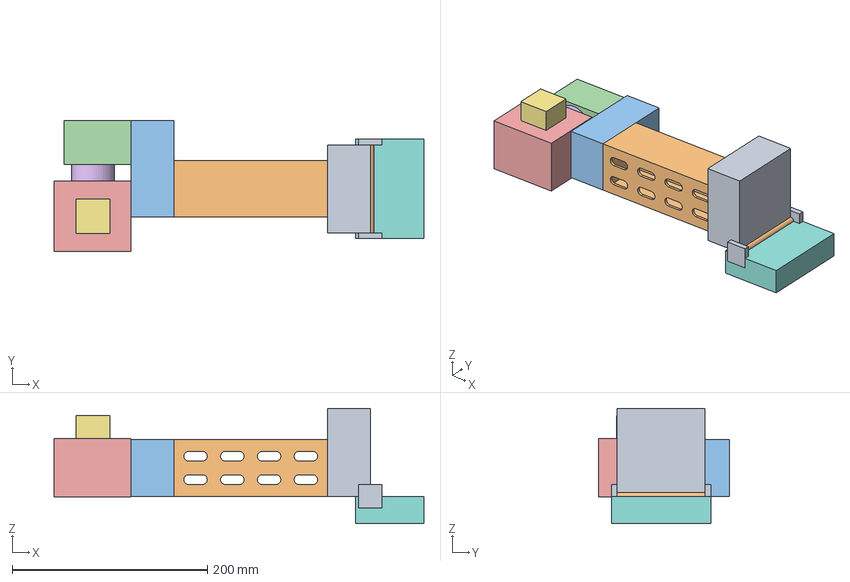
[picture p15: CAD file, 2026-11-07]
hardware/mast/out/mast_stowed.step
379.0 x 134.0 x 118.0 mm
