jacob-rn-wallace/maha-rover/hardware/suspension/link/previous_features.step

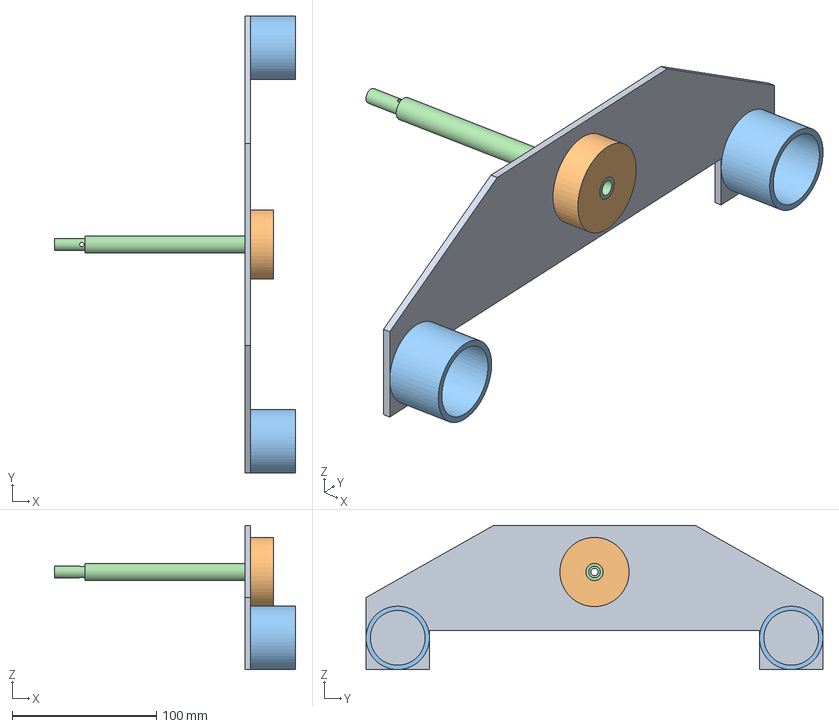
[picture p16: CAD file, 2026-11-08, an earlier design]
hardware/suspension/link/previous_features.step
167.2 x 317.0 x 100.0 mm
