jacob-rn-wallace/maha-rover/docs/images/rover-assembly.png

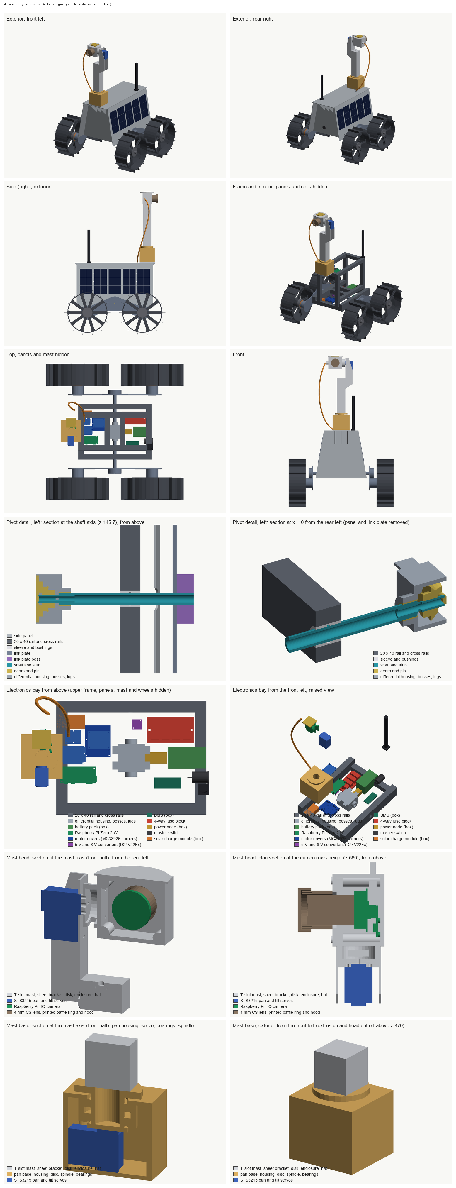
docs/images/rover-assembly.png
