jacob-rn-wallace/maha-rover/hardware/mast/mast.py

"""al-maha mast: replica mast, head and camera, fixed upright.

Replica design guided by the original's CAD figures (original-dimensions.md 3j) and
[S12] (CAM-1 35 x 35 x 73 mm on a pan-tilt gimbal). Dimensions tagged derived are from
the figures; everything else is ASSUMPTION.

The mast is FIXED for now: the original stows flat under 120 mm [S19] and springs up on
landing, but the replica's stowing and deploying are deferred (decision 2026-11-07). A
T-slot extrusion (40 x 40, decided 2026-11-07) stands on a base plate bolted to the deck and carries the printed
bent sheet bracket and head (headb.py) on its end. Pan is a servo in the base and tilt a servo in the bracket
(Feetech STS3215, docs/electronics-spec.md). The earlier hinged design, with a hinge pin,
pedestal and fold sweep, is in commit 20aec90.

Frame as in body.py.

Run:  .venv/bin/python hardware/mast/mast.py
Out:  hardware/mast/out/mast.step
"""
import math
import sys
from pathlib import Path

from build123d import Axis, Box, Compound, Cone, Cylinder, Pos, Rot, export_step

HERE = Path(__file__).parent
sys.path.insert(0, str(HERE.parent / "body"))
sys.path.insert(0, str(HERE))
import body as B  # noqa: E402
import head as H  # noqa: E402
import headb as HB  # noqa: E402
import base as BASE  # noqa: E402

# ---- Positions (3j) ---------------------------------------------------------
TUBE_X = B.MAST_X                  # tube centre; 24.2 ahead of the front axle   derived [3j]
TUBE_W = 58.0                      # width of the printed neck, X and Y (the original's tube measures about 60 x 59)  derived [3j]
EXT = 40.0                         # mast extrusion section, 40 x 40 (narrower than the original's 58 mm tube)  ASSUMPTION
EXT_KG_PER_M = 1.86                # Misumi HFS8-4040 catalogue (sources list 1.73 to 1.90 by variant; get it from the vendor)  stated (catalogue)
PLATE_X, PLATE_Y, PLATE_T = 75.0, 80.0, 3.0   # aluminium base plate on the deck under the die-cast box (75 x 80), fixed by the box's two M4 mounting holes and screws to the deck  ASSUMPTION
TOP_Z = B.TOP_Z                    # top of the head                              stated [S1]

# ---- Rotating parts, measured along the mast from the hinge ----------------
BASE_Z0, BASE_Z1 = B.DECK_TOP_Z, B.DECK_TOP_Z + PLATE_T   # base plate on the deck
_BASE_PARTS, _BASE_INFO = BASE.build(TUBE_X, BASE_Z1)      # pan drive housing, servo, spindle and bearings (base.py)
TUBE_Z0, TUBE_Z1 = _BASE_INFO["z_flange_top"], 597.0  # extrusion from the spindle flange up into the bracket; the original's tube tops out at 577 [3j], this one is raised to 597 (the bracket's web is bolted to it); limit about 600 from the tilt sweep
CAP_T = 6.0                        # aluminium end plate on the extrusion's top end, 40 x 40 x 6, held by one countersunk M10 screw into the tapped centre bore (owner's choice, 2026-11-08). The stack top stays at TUBE_Z1: the extrusion is 6 mm shorter
CAP_SCREW_KG = 0.013               # M10 x 16 countersunk screw (ISO 10642 head: 20 mm across, 5.5 deep; 8.5 mm bore tapped M10)   ASSUMPTION (catalogue figures remembered, not looked up)
EXT_TOP = TUBE_Z1 - CAP_T          # top of the extrusion, under the plate
CAM_Y = B.CAM_Y                    # 28 right of the centreline                   derived [S8], confirmed [3j]
CAM_AXIS_Z = HB.AZ                 # CAM-1 optical axis and tilt axis height: 667 measured on the original's Fig. 1 (stated 660 [S12])
CAM_FRONT_X = B.WHEELBASE / 2 + 77.9   # [S8] 77.9 ahead of the front axle: matches the lens front in [3j]
assert (HB.TX, HB.CY, HB.AZ, HB.FX, HB.Z_EXT) == (TUBE_X, CAM_Y, CAM_AXIS_Z, CAM_FRONT_X, TUBE_Z1)

# ---- Replica masses, kg (ASSUMPTION unless from a catalogue) -----------------------------
# bracket: volume x 2.68 g/cm3 (aluminium sheet); printed parts: volume x PETG; the sideways disk is printed with a hollow core (mass ASSUMPTION);
# servos 55 g each (retailers); the camera body is a Raspberry Pi HQ camera (50 g, retailer), the lens a 4 mm CS lens (49 g, retailer); hardware 0.02
AL_G_CM3 = 2.68
DISK_KG = 0.015
CAMBODY_KG = HB.HQ_KG
MASSES = {"pan and tilt servos": 2 * H.SERVO_MASS, "hardware": 0.02}
ENCLOSURE_KG = HB.ENC_KG           # Takachi AL060605, catalogue (162 g)   stated
PRINTED_HEAD = ("baffle", "hood")


def parts():
    base = Pos(TUBE_X, 0, (BASE_Z0 + BASE_Z1) / 2) * Box(PLATE_X, PLATE_Y, PLATE_T)
    tube = Pos(TUBE_X, 0, (TUBE_Z0 + EXT_TOP) / 2) * Box(EXT, EXT, EXT_TOP - TUBE_Z0)   # slots ignored, as in frame.py
    cap, screw = end_cap()
    hp = HB.head()
    return {"base": base, "tube": tube, "mast cap": cap, "mast cap screw": screw, **hp, **_BASE_PARTS}


def end_cap():
    """The 40 x 40 x 6 aluminium end plate with an 11 mm hole and a 90 degree countersink, and its M10 countersunk screw (head and the shank through the plate; the thread in the bore is not modelled)."""
    z0, z1 = EXT_TOP, TUBE_Z1
    csk_r, hole_r, depth = 10.0, 5.5, 4.5                         # 20 mm head across, 11 mm hole, 90 degree countersink
    plate = Pos(TUBE_X, 0, (z0 + z1) / 2) * Box(EXT, EXT, CAP_T)
    hole = Pos(TUBE_X, 0, (z0 + z1) / 2) * Cylinder(hole_r, CAP_T + 2)
    plate = plate - hole - Pos(TUBE_X, 0, z1 - depth / 2) * Cone(hole_r, csk_r, depth)
    head = Pos(TUBE_X, 0, z1 - depth / 2) * Cone(hole_r, csk_r, depth)
    head = head - Pos(TUBE_X, 0, z1 - 1.5) * Cylinder(2.8, 3.0)                  # socket (round stand-in for the 5 mm hex)
    shank = Pos(TUBE_X, 0, (z0 + z1 - depth) / 2) * Cylinder(5.0, CAP_T - depth)
    return plate, head + shank


def cg_and_moment():
    rot = parts()
    pts = []   # (mass, x, z)
    c = lambda n: rot[n].center()
    pts.append((PLATE_X * PLATE_Y * PLATE_T / 1e3 * 2.70 / 1000.0, c("base").X, c("base").Z))                 # aluminium plate
    pts.append(((EXT_TOP - TUBE_Z0) / 1000.0 * EXT_KG_PER_M, c("tube").X, c("tube").Z))                          # extrusion
    pts.append((rot["mast cap"].volume / 1e6 * AL_G_CM3, c("mast cap").X, c("mast cap").Z))                   # aluminium end plate
    pts.append((CAP_SCREW_KG, c("mast cap screw").X, c("mast cap screw").Z))
    pts.append((rot["bracket"].volume / 1e6 * AL_G_CM3, c("bracket").X, c("bracket").Z))
    for n in PRINTED_HEAD:
        pts.append((H.shell_mass(rot[n]), c(n).X, c(n).Z))
    pts.append((ENCLOSURE_KG, c("enclosure").X, c("enclosure").Z))
    pts.append((rot["antenna hat"].volume / 1e6 * AL_G_CM3, c("antenna hat").X, c("antenna hat").Z))                # aluminium hat disc
    pts.append((HB.GNSS_PATCH_KG, c("GNSS patch").X, c("GNSS patch").Z))
    pts.append((rot["disk"].volume / 1e6 * AL_G_CM3, c("disk").X, c("disk").Z))        # hollow turned aluminium shell (2026-11-08: was printed), by volume
    pts.append((CAMBODY_KG, c("camera body").X, c("camera body").Z))
    pts.append((HB.LENS_KG, c("lens").X, c("lens").Z))
    pts.append((HB.TX_BOARD_KG, c("CSI extender Tx").X, c("CSI extender Tx").Z))
    pts.append((0.005, c("cable gland").X, c("cable gland").Z))                                               # PG7 gland, ASSUMPTION
    for n in ("pan servo", "tilt servo"):
        pts.append((H.SERVO_MASS, c(n).X, c(n).Z))
    pts.append((MASSES["hardware"] + _BASE_INFO["hardware_kg"], TUBE_X, B.DECK_TOP_Z + 30.0))
    pts.append((_BASE_INFO["housing_kg"], c("pan housing").X, c("pan housing").Z))
    pts.append((_BASE_INFO["al_kg"], c("spindle").X, c("spindle").Z))
    pts.append((_BASE_INFO["bearing_kg"], c("pan bearings").X, c("pan bearings").Z))
    m = sum(p[0] for p in pts)
    zc = sum(p[0] * p[2] for p in pts) / m
    xc = sum(p[0] * p[1] for p in pts) / m
    h = zc - B.DECK_TOP_Z                  # height of the centre of mass above the deck
    return m, xc, zc, h, m * 9.81 * h / 1000.0   # N.m about the base (h in mm), Earth gravity, sideways acceleration of 1 g


def _vol(a, b):
    r = a & b
    return 0.0 if r is None else r.volume


def head_checks(p):
    """Head checks: tilt servo between the bracket flanges, pan sweep of the whole turning mast, tilt sweep of the camera unit."""
    ax_p = Axis((TUBE_X, 0, 0), (0, 0, 1))
    ax_t = Axis((TUBE_X, 0, CAM_AXIS_Z), (0, 1, 0))
    br = p["bracket"].bounding_box()
    tv = p["tilt servo"].bounding_box()
    print("\nhead: tilt servo between the bracket flanges (inner width 36) and its horn through the web hole, clear of the sheet (mm3, want 0)")
    print(f"  tilt servo vs bracket: {_vol(p['tilt servo'], p['bracket']):.1f}; servo x {tv.min.X:.1f}..{tv.max.X:.1f} y {tv.min.Y:.1f}..{tv.max.Y:.1f} z {tv.min.Z:.1f}..{tv.max.Z:.1f}; "
          f"bracket x {br.min.X:.1f}..{br.max.X:.1f} y {br.min.Y:.1f}..{br.max.Y:.1f} z {br.min.Z:.1f}..{br.max.Z:.1f}")
    print(f"  bracket vs extrusion: {_vol(p['bracket'], p['tube']):.1f}; disk vs bracket {_vol(p['disk'], p['bracket']):.1f}; enclosure vs bracket {_vol(p['enclosure'], p['bracket']):.1f}")
    print("  camera stack vs die-cast enclosure (mm3, want 0): " + ", ".join(f"{n} {_vol(p[n], p['enclosure']):.1f}" for n in ("camera body", "lens", "baffle", "hood")))
    print("  CSI extender Tx board inside the box (mm3, want 0): " + ", ".join(f"{a} vs {b} {_vol(p[a], p[b]):.1f}" for a in ("CSI extender Tx", "HDMI plug") for b in ("enclosure", "camera body", "lens", "baffle", "hood")) + f", gland vs bracket {_vol(p['cable gland'], p['bracket']):.1f}")
    tb = p["CSI extender Tx"].bounding_box()
    cb = p["camera body"].bounding_box()
    xb0, xp0, xp1, xr1 = HB._txb_x()
    print(f"  Tx board x {tb.min.X:.2f}..{tb.max.X:.2f} y {tb.min.Y:.1f}..{tb.max.Y:.1f} z {tb.min.Z:.1f}..{tb.max.Z:.1f}; box inner back wall x {HB.FX - 73.0:.2f} (the pin tips are {xb0 - (HB.FX - 73.0):.2f} off it, on {HB.TXB_STANDOFF} mm standoffs); "
          f"camera board back face x {cb.min.X + HB.HQ_REAR:.2f} (gap to receptacle top {cb.min.X + HB.HQ_REAR - xr1:.2f}); HQ rear connector block back x {cb.min.X:.2f} (gap to Tx board's PCB top {cb.min.X - xp1:.2f})")
    print(f"  lens recess behind the hood face: {HB.FX - HB.LENS_FRONT:.1f} mm (8.0 as before); HDMI gland hole x {HB.GLAND_X:.1f}, z {HB.AZ:.0f}, diameter {HB.GLAND_D:.1f} in the -y wall")
    eb = p["enclosure"].bounding_box()
    print(f"  enclosure x {eb.min.X:.1f}..{eb.max.X:.1f} y {eb.min.Y:.1f}..{eb.max.Y:.1f} z {eb.min.Z:.1f}..{eb.max.Z:.1f}; the disk (40 mm, x {TUBE_X - 20:.0f}..{TUBE_X + 20:.0f}) reaches {TUBE_X + 20 - eb.max.X:.1f} mm past the box front")
    turning = ("bracket", "tube", "mast cap", "mast cap screw", "spindle", "tilt servo") + HB.TILTING
    static = [p["base"], p["pan housing"], p["pan servo"], p["pan bearings"], p["pan coupling disc"]]
    moving = Compound([p[n] for n in turning])
    worst = 0.0
    for deg in range(-180, 181, 30):
        m_ = moving.rotate(ax_p, deg)
        worst = max(worst, sum(_vol(m_, s_) for s_ in static))
    print(f"\npan sweep, -180 to +180 degrees in 30 degree steps: overlap of the whole turning mast with the base plate, pan housing, servo and bearings: worst {worst:.1f} mm3")
    unit = Compound([p[n] for n in HB.TILTING])
    fixed = [p["bracket"], p["tilt servo"], p["tube"], p["mast cap"], p["mast cap screw"]]
    print("tilt sweep, the camera unit (disk, enclosure, hat, camera) about the tilt axis (x %.1f, z %.0f), overlap with the bracket, tilt servo and extrusion:" % (TUBE_X, CAM_AXIS_Z))
    for sgn, nm in ((1, "positive"), (-1, "negative")):
        first = None
        for deg in range(0, 91, 5):
            u_ = unit.rotate(ax_t, sgn * deg)
            if sum(_vol(u_, f_) for f_ in fixed) > 1.0 and first is None:
                first = deg
        print(f"  {nm} tilt: first contact at {first if first is not None else 'none up to 90'} degrees (the original tilts plus or minus 75 degrees [S19])")


if __name__ == "__main__":
    out = HERE / "out"
    out.mkdir(exist_ok=True)
    body_parts, _ = B.build_rover()
    deck = body_parts["body"]
    cells = Compound([v for k, v in body_parts.items() if k.startswith("cell")])
    hull = Compound([deck, cells])

    p = parts()
    allp = Compound(list(p.values()))
    bb = allp.bounding_box()
    print(f"mast x {bb.min.X:.0f}..{bb.max.X:.0f}, y {bb.min.Y:.0f}..{bb.max.Y:.0f}, z {bb.min.Z:.0f}..{bb.max.Z:.0f}")
    print(f"top z {bb.max.Z:.0f} (stated 700); camera axis z {CAM_AXIS_Z:.0f}; lens front x {CAM_FRONT_X:.1f} "
          f"({B.WHEELBASE / 2:.1f} + 77.9); body front end x {B.BODY_X0 + B.SIDE_PLATE_LEN / 2:.0f}")
    print(f"base plate x {TUBE_X - PLATE_X / 2:.0f}..{TUBE_X + PLATE_X / 2:.0f}, y +-{PLATE_Y / 2:.0f}; extrusion {EXT:.0f} x {EXT:.0f}, z {TUBE_Z0:.0f}..{EXT_TOP:.0f} under a {CAP_T:.0f} mm end plate to z {TUBE_Z1:.0f}; deck half-width {B.TOP_WIDTH / 2:.0f}, "
          f"deck x +-{B.DECK_LEN / 2:.0f}")
    print(f"overlap with body+cells (mm3, want 0): {(allp & hull).volume:.1f}")
    # the base plate must sit on the deck
    deck_top = Pos(B.BODY_X0, 0, B.DECK_TOP_Z + 0.5) * Box(B.DECK_LEN, B.TOP_WIDTH, 1.0)   # 1 mm slab just above the deck
    print(f"base plate footprint on the deck plate (mm2): {(p['base'] & deck_top).volume / 1.0:.0f} of {PLATE_X * PLATE_Y:.0f}")

    m, xc, zc, h, tq = cg_and_moment()
    print(f"\nreplica mast (ASSUMPTION masses): {m:.2f} kg, centre of mass {h:.0f} mm above the deck")
    print(f"moment at the base for a sideways acceleration of 1 g: {tq:.2f} N.m "
          f"(rover tilted 45 degrees: the same; a 20 degree slope gives {tq * math.sin(math.radians(20)):.2f} N.m)")

    print(f"extrusion {(EXT_TOP - TUBE_Z0):.0f} mm x {EXT_KG_PER_M} kg/m = {(EXT_TOP - TUBE_Z0) / 1000 * EXT_KG_PER_M:.2f} kg; its slots carry the camera and servo cables")
    print()
    BASE.checks(p, _BASE_INFO, TUBE_X, moment_1g_nm=tq, mast_kg=m)
    head_checks(p)

    export_step(Compound(list(p.values()), label="mast"), str(out / "mast.step"))
