jacob-rn-wallace/maha-rover/hardware/body/body.py

"""al-maha body: parametric envelope model (build123d), first pass.

Replica of the Rashid-1 body, wheels and mast as a dimensional
envelope: solid parts, thin solar cell plates, no internal structure, no
suspension. 
Millimetres. Rover frame: X forward, Y left, Z up, origin on the ground
(wheel contact line) under the midpoint between the axles, on the centreline.

Every value names its status from docs/original-dimensions.md (section in
brackets): stated / derived / (unverified). ASSUMPTION marks a modelling
choice with no source. Change it when a source appears.

Run:  .venv/bin/python hardware/body/body.py
Out:  hardware/body/out/rover.step, rover.stl, and a printed check table.
"""
import math
import sys
from pathlib import Path

from build123d import (
    Box, Compound, Cylinder, Plane, Polygon, Pos, Rot, extrude, export_step,
    export_stl,
)
from build123d import Vector

sys.path.insert(0, str(Path(__file__).parent.parent / "wheel"))
from wheel import build_wheel  # noqa: E402

# ---- Body (section 3e, 3f) -----------------------------------------------
UNDERSIDE_Z = 124.0      # underside above ground                 derived [3f]
DECK_TOP_Z = 348.0       # deck top above ground                  derived [3f]
TOP_WIDTH = 164.0        # width just below the deck lip          derived [3f]
SIDEWALL_DEG = 10.0      # from vertical, panels at 80 degrees    stated [S20], 3f
SIDE_PLATE_LEN = 380.0   # body length (side plates)              derived [3e]
DECK_LEN = 401.0         # top plate length                       stated [S11]
DECK_T = 3.0             # top plate thickness (aluminium sheet, frame.py)   ASSUMPTION
BODY_X0 = 0.0            # body centre along X vs the axle midpoint
                         #                                        (unverified; symmetric)

# ---- Wheels (section 2, 3e, 3f) ------------------------------------------
WHEELBASE = 273.0        # hub to hub; stated 270 rounded         derived [3e]
TRACK = 415.4            # wheel centre to centre                 derived [S8]
HUB_Z = 100.0            # = rim radius, ground at the rim line.
                         # [3e] reads 101. Grouser tips (115) then
                         # sit 15 mm below the line, as in the CAD frame it was
                         # measured in                           derived

# ---- Mast and cameras (section 4) ----------------------------------------
TOP_Z = 700.0            # top of the CAM-1 head, mast deployed   stated [S1]
MAST_X = WHEELBASE / 2 + 24.2   # mast tube centre ahead of the front axle; measured
                         # on the native side view (3j), refines 35 of [3e]  derived
MAST_D = 20.0            # old placeholder tube (used only by hardware/mass/budget.py)
HEAD_W, HEAD_L, HEAD_H = 50.0, 50.0, 60.0   # old placeholder head (same)
CAM_AXIS_Z = 660.0       # CAM-1 optical axis height              stated [S12]
CAM_X = WHEELBASE / 2 + 77.9 - 36.5   # CAM-1 tube centre: the 77.9 of [S8] matches the
                         # lens FRONT in the side view (3j), less half the 73 mm tube  derived
CAM_Y = -28.0            # 28 right of centreline (Y is left)     derived [S8]
CAM_TUBE = (73.0, 35.0, 35.0)   # L x W x H optical tube          stated [S12]

# ---- Solar cells (section 3g, 3h, 5) -------------------------------------
N_COLS, N_ROWS = 5, 3    # slots per side, all landscape          derived [3e, 3g]
PIECES_PER_SLOT = 2      # tiled back-contact pieces per slot (decided 2026-11-07)
PIECE_W, PIECE_H = 31.0, 41.6   # a 125 x 41.6 mm third-cut strip cut in four (31.25 less the kerf)  stated (retailer) / derived
PIECE_GAP = 0.5          # gap between the two pieces of a slot   ASSUMPTION
SLOT_W = PIECES_PER_SLOT * PIECE_W + (PIECES_PER_SLOT - 1) * PIECE_GAP   # 62.5 mm
CELL_W, CELL_H = PIECE_W, PIECE_H   # one plate per piece
PITCH_U, PITCH_V = 71.6, 42.5   # slot columns on the original's pitch [3g]; rows at 42.5 so the 41.6 mm
                         # strips clear (the original's row pitch is 41)    derived [3g] / ASSUMPTION
CLIP = 0.0               # plain rectangles (pieces from the outer thirds of a cell have one clipped corner: not modelled)
CELL_T = 0.8             # piece (about 0.15 mm) plus adhesive and a clear laminate over it       ASSUMPTION
HOLE_D = 5.0             # wire hole through the side panel at both ends of every row, under the end piece,
                         # for the ribbon or wire that carries the row's string end inside   ASSUMPTION
HOLE_X = 107.1           # x of those holes: in the 9.7 mm gap between the 4th and 5th cell columns, clear of the posts (x 114 to 134) and inside the recessed end panels (136.5)
FIELD_Z = 255.0          # field centre height on the face: the cells span z 196 to 314 in the side view
                         # of the original ([S5] Fig. 15, pixel scan, 3k); was the mid-wall height
                         # 233.5, an assumption, which put the lowest row over the wheels   derived

# ---- Stowed mast (section 3h) --------------------------------------------
MAST_STOWED_MAX = 120.0  # max stowed height above the top cover  stated [S19]
STOW_DIR = -1            # mast folds rearward (-X)               ASSUMPTION

TARGETS = {              # for the printed check
    "length over wheel rims": (470.0, "stated [S1]"),
    "width over wheels":      (505.0, "stated [S1]; CAD 497 [3f]"),
    "height, mast deployed":  (700.0, "stated [S1]"),
}


def body():
    h = DECK_TOP_Z - DECK_T - UNDERSIDE_Z    # the wedge ends under the deck plate
    bottom_w = TOP_WIDTH + 2 * h * math.tan(math.radians(SIDEWALL_DEG))
    pts = [(-bottom_w / 2, UNDERSIDE_Z), (bottom_w / 2, UNDERSIDE_Z),
           (TOP_WIDTH / 2, DECK_TOP_Z - DECK_T), (-TOP_WIDTH / 2, DECK_TOP_Z - DECK_T)]
    # Plane.YZ: local x = world Y, local y = world Z, normal +X
    wedge = extrude(Plane.YZ * Polygon(*pts, align=None),
                    amount=SIDE_PLATE_LEN / 2, both=True)
    deck = Pos(0, 0, DECK_TOP_Z - DECK_T / 2) * Box(DECK_LEN, TOP_WIDTH, DECK_T)
    return Pos(BODY_X0, 0, 0) * (wedge + deck), bottom_w


def wheels():
    w = Rot(90, 0, 0) * build_wheel()          # axle Z -> Y
    return [Pos(sx * WHEELBASE / 2, sy * TRACK / 2, HUB_Z) * w
            for sx in (1, -1) for sy in (1, -1)]


def cells():
    """Two fields of 5 x 3 slots, two pieces each, one per sloped side face (thin plates, 60 in all)."""
    t = math.tan(math.radians(SIDEWALL_DEG))
    c, sn = math.cos(math.radians(SIDEWALL_DEG)), math.sin(math.radians(SIDEWALL_DEG))
    hw = lambda z: TOP_WIDTH / 2 + (DECK_TOP_Z - DECK_T - z) * t
    W, H = PIECE_W / 2, PIECE_H / 2
    piece = extrude(Polygon((-W, -H), (W, -H), (W, H), (-W, H), align=None), amount=CELL_T)
    out = []
    for sy in (1, -1):
        # plane y axis runs up the slope; z is the outward normal
        normal = Vector(0, sy * c, sn)
        xdir = Vector(-sy, 0, 0)
        for i in range(N_COLS):
            for j in range(N_ROWS):
                u0, v = (i - (N_COLS - 1) / 2) * PITCH_U, (j - (N_ROWS - 1) / 2) * PITCH_V
                up = Vector(0, -sy * sn, c)
                o = Vector(BODY_X0, sy * hw(FIELD_Z), FIELD_Z) + up * v
                pl = Plane(origin=o, x_dir=xdir, z_dir=normal)
                for k in range(PIECES_PER_SLOT):
                    du = (k - (PIECES_PER_SLOT - 1) / 2) * (PIECE_W + PIECE_GAP)
                    out.append(pl * Pos(u0 + du, 0, 0) * piece)
    return out


def solar_holes(length=6.0, d=None):
    """Cylinders along the wall normal at the 12 wire holes (6 per side: both ends of each of the 3 rows, under the
    end pieces), starting at the outer face and running `length` inward. Subtract from the shell to cut the holes."""
    d = HOLE_D if d is None else d
    t = math.tan(math.radians(SIDEWALL_DEG))
    c, sn = math.cos(math.radians(SIDEWALL_DEG)), math.sin(math.radians(SIDEWALL_DEG))
    hw = lambda z: TOP_WIDTH / 2 + (DECK_TOP_Z - DECK_T - z) * t
    out = []
    for sy in (1, -1):
        n = Vector(0, sy * c, sn)
        for j in range(N_ROWS):
            v = (j - (N_ROWS - 1) / 2) * PITCH_V
            for sx in (1, -1):
                o = Vector(BODY_X0 + sx * HOLE_X, sy * hw(FIELD_Z), FIELD_Z) + Vector(0, -sy * sn, c) * v
                pl = Plane(origin=o, z_dir=n)
                out.append(pl * Pos(0, 0, -length / 2) * Cylinder(d / 2, length))
    return out


def mast():
    """The replica mast and camera from hardware/mast/mast.py (fixed upright).
    Imported here, not at the top, because mast.py imports this module."""
    sys.path.insert(0, str(Path(__file__).parent.parent / "mast"))
    import mast as mast_model
    return Compound(list(mast_model.parts().values()))


def build_rover():
    b, bottom_w = body()
    parts = {"body": b, "mast": mast()}
    for i, cl in enumerate(cells()):
        parts[f"cell{i}"] = cl
    for i, w in enumerate(wheels()):
        parts[f"wheel{i}"] = w
    return parts, bottom_w


if __name__ == "__main__":
    parts, bottom_w = build_rover()
    rover = Compound(list(parts.values()), label="al-maha")
    out = Path(__file__).parent / "out"
    out.mkdir(exist_ok=True)
    export_step(rover, str(out / "rover.step"))
    export_stl(rover, str(out / "rover.stl"))

    print(f"cells: {sum(k.startswith('cell') for k in parts)} (target 60), "
          f"all valid {all(p.is_valid for k, p in parts.items() if k.startswith('cell'))}")

    bb = rover.bounding_box()
    wb = Compound([v for k, v in parts.items() if k.startswith("wheel")]).bounding_box()
    print(f"all parts valid : {all(p.is_valid for p in parts.values())}")
    print(f"body underside width {bottom_w:.0f}  (3a measured about 230, 3f top 164 + 10 deg)")
    print(f"{'check':26s}{'model':>9s}{'target':>9s}   source")
    rows = {
        "length over wheel rims": 2 * (WHEELBASE / 2) + 2 * 100.0,
        "width over wheels": wb.size.Y,
        "height, mast deployed": bb.max.Z,
    }
    for k, v in rows.items():
        t, s = TARGETS[k]
        print(f"{k:26s}{v:9.1f}{t:9.1f}   {s}")
    print(f"bbox over grouser tips: {bb.size.X:.1f} x {bb.size.Y:.1f} x {bb.size.Z:.1f}")
    print(f"lowest point Z  : {bb.min.Z:.1f}  (grouser tips below the rim line)")
