jacob-rn-wallace/maha-rover/(commit log)

2026-11-06 Add sourced original-rover dimensions; update CLAUDE.md and README
    Add docs/original-dimensions.md: Rashid-1 dimensions from MBRSC and
    instrument-team papers (Space Science Reviews ELM collection, EGU21,
    IAC-21), each value tagged with source and stated/derived/unverified
    status. Records open conflicts (wheel width 80 vs 168 mm, body size,
    mass) and gaps (stowed envelope, sidewall angle, panel size,
    suspension), and compares the provisional design against the original.
    CLAUDE.md and README.md now point to that file, describe the
    provisional design as inspired by Rashid rather than binding, and
    replace the press-figure headline numbers with sourced ones.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
2026-11-06 Add figure- and video-derived body dimensions; ignore all do-not-track folders
    Section 3a/3b of docs/original-dimensions.md record values measured from the
    rear-view CAD in the Operational Concepts paper and a turntable render, tagged
    as derived. Reconciles the Langmuir paper's 20 x 20 x 40 cm body size.
2026-11-07 Add final-configuration CAD measurements (section 3e); mark turntable video as a different revision
    Claude-Session: https://claude.ai/code/session_01B6dv3N2YiS7jssiGkt8rPk
2026-11-07 Record flight-model photo sidewall angle (about 9 deg); note unused wheel-legged rover paper
    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
2026-11-07 Add orthographic front view of final CAD (section 3f, [S18]); settle width over wheels, wheel width and sidewall angle
    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
2026-11-07 Add Khalifa thesis wheel data ([S23]), wheel design variants, grouser-count conflict, new conference sources
    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
2026-11-07 Add wheel specification (docs/wheel-spec.md); record 36 degree spoke spacing in the final CAD wheel; link from README and CLAUDE.md
    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
2026-11-07 Add thesis figure measurements: ten ribs at 36 degrees, rib width, hub tube, rim band, grouser tip radius; correct wheel variant note
    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
2026-11-07 Record grouser plate thickness (from flight PRS photographs), slot width, and rough rib thickness
    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
2026-11-07 Add Moneycontrol article ([S24]): manufacturer, materials, timeline; record hardware-photo observations of the wheel
    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
2026-11-07 Add first parametric wheel CAD model (build123d) and document it
    hardware/wheel/wheel.py builds the Rashid wheel from docs/wheel-spec.md:
    200 mm rim, 80 mm wide, 14 grousers of 15 mm, ten ribs at 36 degrees on
    two axial layers, 50 mm hub tube. Checks to 230 mm over tips and 80 mm
    wide as one valid solid. Unsourced choices are marked in the script and
    listed in wheel-spec.md section 6. STEP tracked, STL ignored.
    Also record the outstanding wheel questions sent to the thesis advisors,
    and update README and CLAUDE.md.
    Claude-Session: https://claude.ai/code/session_01B6dv3NREV4B9HZuFEEB2Rg
    [wheel.step]
2026-11-07 Model ribs as T-sections; record the T cross-section observation
    The thesis FE figures (Fig. 68a, 91, 92) show each rib with a web on one
    face only. wheel.py now builds T ribs with the web on the face pointing
    away from the wheel mid-plane, the two layers mirrored (owner's working
    assumption). Web height 6 mm and thickness 2 mm are unsourced guesses;
    WEB_H = 0 restores flat plates.
    wheel-spec.md and original-dimensions.md: add the cross-section row,
    replace the single rib thickness estimate with plate thickness, web height
    and web thickness as separate unknowns.
    Claude-Session: https://claude.ai/code/session_01B6dv3NREV4B9HZuFEEB2Rg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
    [wheel.step]
2026-11-07 Add body envelope model; replace provisional design with settled figures
    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
    [rover.step]
2026-11-07 Body model: add 5 x 3 solar cell fields, stowed mast; fix wedge angle
    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
    [rover.step, rover_stowed.step]
2026-11-07 Add BOM skeleton
    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
2026-11-07 Drive: 37 mm gearmotors without encoders; hub clearance check
    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
2026-11-07 Drive: Pololu 37D shortlist from datasheet, wheel support concept, clearance check
    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
2026-11-07 Fix stall current in drive-spec (5.5 A per datasheet)
    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
2026-11-07 Suspension: passive differential with side arms, clearance sweep, spec
    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
    [rover_drive.step]
2026-11-07 Suspension: pivot and link plate from CAD figures (3i); README brought in line with scope
    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
    [rover_drive.step]
2026-11-07 Body interior: shell, differential mount, shaft bearings, electronics layout
    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
    [interior.step, rover_drive.step]
2026-11-07 Mast: replica mast, hinge, head and camera from CAD figures (3j); body model uses it
    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
    [interior.step, mast_deployed.step, mast_stowed.step, rover.step, rover_drive.step, rover_stowed.step]
2026-11-07 Electronics shortlist (controller, camera, drivers, servos, cells); mast spring check
    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
    [interior.step, mast_deployed.step, mast_stowed.step]
2026-11-07 Mast: fixed upright, stowing deferred; remove hinge, pedestal and stowed models
    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
    [interior.step, mast.step, mast_deployed.step, rover.step, rover_drive.step, rover_stowed.step]
2026-11-07 Chassis: 20 x 20 T-slot frame behind sheet panels, bearing plates, checks and spec
    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
    [frame.step, interior.step, mast.step, rover.step, rover_drive.step]
2026-11-07 Size the drive for the 10 kg design mass; record the two-pass mass plan
    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
2026-11-07 Record the 10 kg target and two-pass plan in the scope and frame spec
    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
2026-11-07 Record the 10 kg target and two-pass plan in CLAUDE.md
    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
2026-11-07 README: current status, mass target, T-slot chassis, how to run the CAD
    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
2026-11-07 Chassis joints and panel fixing: brackets, printed wedges, screw counts, deck as lid
    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
    [frame.step, interior.step, mast.step, rover.step, rover_drive.step]
2026-11-07 Solar provisions: wire holes, 1 mm cell stack, charge controller space, electrical options, spec
    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
    [frame.step, interior.step, mast.step, rover.step, rover_drive.step]
2026-11-07 Move the solar charge controller clear of the bottom side rail; update numbers
    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
    [frame.step, interior.step]
2026-11-07 Decide on cut silicon cells; record cutting practice, cautions and wiring
    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
2026-11-07 Solar: compare full-outline cut, inset smaller, and tiled small cells for silicon
    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
2026-11-07 Point to the private companion repo; drop the do-not-track folders
    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
2026-11-07 Solar wiring plan: serpentine, boards on the posts, per-option topologies, lead lengths
    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
2026-11-07 Solar charger shortlist: BQ25798, LT3652, CN3722, matched to the cell options
    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
2026-11-07 Settle the cell option (cut silicon, 2 mm tolerance, buck-boost); add cutting references
    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
2026-11-07 Solar: search for one-cut and pre-clipped silicon cells; no clean match, add F4 (Futurlec 60 x 30)
    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
2026-11-07 Cells: Futurlec SZGD6030 plain on the original's grid; holes into the row gaps; docs updated
    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
    [frame.step, interior.step, mast.step, rover.step, rover_drive.step]
2026-11-07 Solar charger board: search for ready-made options, BQ25798 board spec, MPPT init script
    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
2026-11-07 Charger: broader search, evaluation boards first, custom board as last resort
    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
2026-11-07 Solar: AnySolar module survey; closest to 69 x 39 and effect on the charger
    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
2026-11-07 Solar: cell mockups on the panel; correct the field height from the original's side view (3k)
    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
    [frame.step, interior.step, mast.step, rover.step, rover_drive.step]
2026-11-07 Primary cell: AnySolar SM261K10TF (datasheet, pads on the back, 60 holes, 16.7 V string); Futurlec as fallback
    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
    [frame.step, interior.step, mast.step, rover.step, rover_drive.step]
2026-11-07 Charger spec: is a converter needed with each cell option
    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
2026-11-07 Charger spec: cheap buck 2S MPPT modules found, what MPPT means on them, pre-use checks
    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
2026-11-07 Solar: total-cost comparison of cell and charger routes, no custom board
    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
2026-11-07 Solar: decide on tiled back-contact pieces, two per slot, with a cheap buck module; CAD, wiring, docs updated
    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
    [frame.step, interior.step, mast.step, rover.step, rover_drive.step]
2026-11-07 Replica mass and centre of mass from the CAD: 9.2 kg, tip angles, levers for a second pass
    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
2026-11-07 Power system: BMS, fusing, switch, servo regulator, current budget, wire sizes, motor wires through hollow pivot shafts
    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
    [frame.step, interior.step, rover_drive.step]
2026-11-07 Electronics spec: servo supply note, runtime pointer
    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
2026-11-07 Differential: bevel gear train sized (module 1.5 mitre gears), 8 mm tube shafts, 688 bearings, motor current cap, box housing; docs updated
    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
    [frame.step, interior.step, mast.step, rover.step, rover_drive.step]
2026-11-07 Full assembly script, rendered views and a status of what is modelled
    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
2026-11-07 Frame: all extrusions vertical or horizontal (sloped panels stand off on printed ribs, bearing standoff tubes); mast: 40x40 T-slot extrusion on a base plate; interior parts moved, docs and mass updat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
    [frame.step, interior.step, mast.step, rover.step, rover_drive.step]
2026-11-07 Frame: stepped design from the owner's sketch (wide bottom frame, narrow top frame, vertical posts on the bottom end rails); ribs and standoff tubes dropped; interior parts back in place; docs and ma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
    [frame.step]
2026-11-07 Frame: close the bottom corners (side rails full length, end cross rails between them, connectivity check); side panels become separate plates on four pivot standoffs each, 10 mm off the frame, as in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
    [frame.step, interior.step, mast.step, rover.step, rover_drive.step]
2026-11-07 Bottom side rails: single members with the pivot shaft through a drilled hole (bottom frame centred on the pivot axis, floor on spacers, flanged bushings replace the bearing plates); docs and mass up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
    [frame.step, interior.step, mast.step, rover.step, rover_drive.step]
2026-11-07 Strength check of the drilled bottom rail (rail_check.py): beam fine, bushings alone fail the 3x design case, a second shaft support in the differential housing fixes it; documented
    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
2026-11-07 Pivot shaft resized for bending (12/8 tube, 8/5 stub), second support in the differential housing wall, bottom side rails 20x40 with 16 mm pivot holes (floor back on the rails), no radial hole in the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
    [frame.step, interior.step, mast.step, rover.step, rover_drive.step]
2026-11-07 Pivot open points: shaft material (4130, E355 fallback), igus-type bushings in a bonded sleeve and a housing boss, separate bonded gear stub, shaft bonded 20 mm into the link plate boss, housing lugs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
    [frame.step, interior.step, mast.step, rover.step, rover_drive.step]
2026-11-07 Assembly render: two sectioned close-ups of the left pivot (shaft axis section, x = 0 section) with legends; docs note
    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
2026-11-07 Electronics boards as dimensioned models (Pi Zero 2 W, MC33926 carriers, D24V22Fx converters, fuse block, rocker switch) from vendor drawings; interior and rear panel updated; two electronics bay vie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
    [frame.step, interior.step, mast.step, rover.step, rover_drive.step]
2026-11-08 Mast head: hollow printed shells with real STS3215 pan and tilt servos and a Camera Module 3 (from vendor drawings), fit and sweep checks; the tilt sweep fails at 5 degrees (recorded as an open desig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
    [frame.step, interior.step, mast.step, rover.step, rover_drive.step]
2026-11-08 Record CAM-1 camera assembly findings from the 3D Plus datasheet and the paper figures (original-dimensions 3l)
    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
2026-11-08 Rough concept model of the mast head with a CASPEX camera stack in the open-frame layout of the CAD figures (head_concept.py, head-concept.png)
    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
2026-11-08 Head concept redone to the owner's reading: octagonal mast, lateral overhang with tilt servo pocket, sideways disk, cube enclosure with CASPEX lens assembly, tilting antenna hat
    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
2026-11-08 Mast pan base: whole mast turns on a spindle in two bearings above the pan servo in a printed housing on the deck (base.py); extrusion shortened; neck no longer holds the pan servo; two base views in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
    [mast.step]
2026-11-08 Head concept v3: utilitarian layout (adapter plate, arm with tilt servo window, disk, cube enclosure, hat); tilt sweep clears 90 degrees both ways
    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
2026-11-08 Head concept v4: bent sheet bracket (one blank, two folds) replaces adapter plate and printed arm; tilt sweep still clears 90 degrees
    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
    [head_concept.py]
2026-11-08 Bracket outline follows the original's S-bend arm; flanges straddle the extrusion and bolt into the side slots
    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
2026-11-08 Merge the bent sheet bracket head into the mast model (headb.py), assembly render and docs; mast 1.05 kg, replica 10.13 kg; camera unit tilts 90 degrees both ways
    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
    [mast.step, rover.step]
2026-11-08 Camera enclosure is now a die-cast aluminium box (Takachi TD6-6-4, from the catalogue drawing); lens stack outside the cover; mast 1.09 kg, replica 10.17 kg
    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
    [mast.step]
2026-11-08 Bracket rebuilt as folded panels with mitre-cut flaps so it can be formed from a flat blank; flat pattern drawing (bracket-flat.png)
    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
    [mast.step]
2026-11-08 Adopt the owner's bracket redesign (mast_redesign.step): S-shaped side plates and a web on the camera side, servo pocket open outward; camera moved to y -23.5; remove the flat-pattern drawing (the pl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
    [mast.step]
2026-11-08 replica-mass: match the 10.16 kg figure
    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
2026-11-08 Adopt the simplified bracket (mast_simplified_in_situ.step): web on the extrusion's +y face with two edge flanges traced from the original's arm; head at y -30.5; mast 1.06 kg, replica 10.15 kg
    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
    [mast.step]
2026-11-08 Raise the mast extrusion to z 597 (tilt sweep limit about 600) and add a third bolt in the bracket web; mast 1.10 kg, replica 10.18 kg
    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
    [mast.step]
2026-11-08 Die-cast pan box (Takachi AL080807, lid on top) with a bearing tower under the lid; deeper die-cast camera box (Takachi AL060605) centred on the tilt axis; camera axis at z 667 and camera at y -28 wi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
    [mast.step]
2026-11-08 Refresh the second-pass mass levers after the die-cast boxes (link plate stress estimate, wheel material, mast tube, base plate); package to about 9.72 kg
    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
2026-11-08 Mass second pass applied: link plates 4 mm (boss 16 mm), wheels in ASA, mast base plate 3 mm; the T-slot mast column is kept; replica 9.88 kg
    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
    [mast.step, rover_drive.step]
2026-11-08 Head: square hood window; Pi HQ camera with a 4 mm CS lens (off the shelf) behind a printed baffle ring and hood; tilt servo mounted to the web on its four front-face holes; disk resolved as horn cou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
    [frame.step, interior.step, mast.step]
2026-11-08 Tilt disk in turned aluminium instead of print (+0.011 kg); replica 9.93 kg
    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
    [mast.step]
2026-11-08 Record that the top plate is Rashid's S-band patch antenna (COM-S) and the antenna options for the hat
    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
2026-11-08 Hat becomes a GNSS patch on an aluminium ground-plane disc; vertical 2.4 GHz dipole on the deck 290 mm behind the mast (from the antenna paper); record the paper's antenna facts and correct the anten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
    [mast.step]
2026-11-08 Antenna and radio chain (GNSS receiver, 2.4 GHz options, cable losses, servo bus), camera cable length risk, Pi Zero 2 W against full-size Pis; sleeve antenna paper recorded as S28
    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
2026-11-08 2.4 GHz antenna at the paper's length: AIR802 ANRD2403-RSP, 158 mm black RP-SMA dipole (top at z 512)
    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
2026-11-08 Interior: Pi, GNSS receiver and servo bus adapter hung from the deck underside near the mast entry (new board models); camera cable route from the CAD (570 mm, 190 mm shorter); disc cable hole correc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
    [frame.step, interior.step, mast.step]
2026-11-08 Option A: round-cable CSI extender (Tx pod on the camera box, Rx under the deck, 1 m RJ45 cord); cable chamber above the pan lid with a raised flange and a notched aluminium ring; deck hole; disc pla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
    [interior.step, mast.step]
2026-11-08 Camera-link cable hangs loose like the original's harness (owner's photographs): cable chamber, raised flange and notched ring removed, loose-loop cord modelled to a deck gland, route length 664 mm o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
    [mast.step]
2026-11-08 Mass: 10 kg is the goal, 10.5 kg the ceiling (owner); no part weakened to reach 10; antenna stays a plain rod without the three-leg stand
    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
2026-11-08 Original-dimensions 3n: recessed lower end panels measured from the dense cloud and the front view (about 30 mm, ledge at z about 245)
    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
2026-11-08 Recessed lower end panels to the wheel axle line below a ledge at z 245 (owner's reading of the CAD models): interior cavity and shell, frame bottom rails and posts, electronics moved, switch on the 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
    [frame.step, interior.step, mast.step, rover_drive.step]
2026-11-08 End panels recessed full height to the wheel axle line (no overhanging upper box); rail under the mast removed, mast base bolted to the deck alone; every rail and post ends at x 134.3; solar wire hol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
    [frame.step, interior.step, mast.step, rover.step]
2026-11-08 Gussets under the deck overhang at both ends (three per end, from the perspective CAD views); mast base bolted to the deck over the outer gussets, estimate and open items; replica 9.56 kg
    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
    [frame.step, interior.step, mast.step]
2026-11-08 Link plate: the owner's STEP outline (R35 lobes at the hubs and the pivot, 12 mm hole at the original's place) replaces the assumed outline; sweep and clearances unchanged; replica 9.55 kg
    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
    [frame.step, link_plate.step, rover_drive.step]
2026-11-08 STEP of the previous link design's features (boss, hub sleeves, shaft) in the owner's plate coordinates, for the plate redesign
    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
    [previous_features.step]
2026-11-08 previous_features.step now includes the previous link plate outline too
    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
    [previous_features.step]
2026-11-08 Final link design from link_plate.step: plate, boss, hub sleeves and shaft all built from the owner's file; pivot detail section nudged so the imported shaft meshes; checks unchanged, replica 9.55 kg
    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
    [link_plate.step, rover_drive.step]
2026-11-08 Refresh docs/model-status.md: recessed ends and gussets, owner's link design, frame without the mast rail, 186 parts, replica 9.55 kg, what is placeholder, not modelled, not designed and unverified
    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
2026-11-09 Move the CSI extender Tx board inside the camera box: Arducam B0091 (CSI to HDMI), audio jack desoldered
    Measured from the vendor STEP and datasheet (sizes only, files stay in the private repo): PCB 25.2 x 27.83 x 1.67, HDMI receptacle 6.08 tall, four M2 holes 21.0 x 12.5.
    The Tx board sits on four 3 mm M2 standoffs behind the HQ board with the receptacle toward the camera; no camera shift needed (lens recess stays 8 mm).
    Pod and ribbon slot removed; a Ø10 gland hole in the -y wall takes the HDMI cord (slim-boot plug assumed). Rx board model and cable route updated; replica still 9.55 kg.
    Clearances 0 mm3; tilt and pan sweeps clear. Docs updated with sources and open items.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
    [interior.step, mast.step]
2026-11-09 Camera link open items: HQ connector corrected, 2 mm standoffs, slim-plug envelope, PG7 gland, estimates
    HQ camera brief p. 4: the FPC connector stands 2.75 mm behind the board and is 5.71 mm tall at the bottom edge (the model had 5.71 as the depth).
    Standoffs 3 -> 2 mm (plug axis back so a 9.1 mm thick plug passes the HQ board); gap above the receptacle 1.5 mm.
    Plug envelope 16.2 x 8.0 x 21 from slim HDMI cable listings; PG7 gland (hole 12.5) modelled outside the -y wall, clear through the tilt sweep.
    Docs: ribbon route feasibility, standoff fixing, gland, plug and heat estimate, with what is still open.
    Claude-Session: https://clau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
    [mast.step]
2026-11-09 Camera link: B0091 compatibility researched (HQ camera, Pi Zero, 22-way cable, full 19-wire HDMI cord)
    Vendor and retailer pages list the HQ camera and the Zero boards as supported (untested); pack contents differ between sellers, so the 22-way cable must be checked.
    The cord must carry all 19 HDMI conductors straight through. Docs updated; remaining open items listed.
    Claude-Session: https://claude.ai/code/session_01B6dv3Nw7aBncoqzJ3gS15U
2026-11-09 Camera link: named cord (Lindy CROMO Slim 41671, 1 m), plug envelope from its datasheet, 23.8 mm room corrected
    Plug envelope 16.2 x 6.8 x 21 mm (Lindy; max connector 16.2 x 13.8 x 6.8 on the 1 m sheet). C2G 41363 hood (25 mm) is 1.2 mm too long; StarTech slim is 0.1 mm too thick.
    Room from receptacle mouth to the -y wall is 23.8 mm (the notes said 28). The 1 m sheet gives no jacket diameter, bend radius or pinout; recorded as such.
    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
    [mast.step]
2026-11-09 Rebuild rover.step with the Tx board inside the camera box (the full-rover export was stale); drop leftover Tx pod wording
    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
    [rover.step]
2026-11-09 Reload renders: head concept (gland colour added, no Tx pod), rover assembly, disk section
    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
2026-11-09 Simulation phase 1: sim-ready export (9 rigid bodies, glTF + JSON of joints, masses, camera), three.js viewer scaffold, Pages workflow, docs/sim-spec.md
    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
2026-11-09 Sim export: slotted T-slot profiles (20x20, 20x40, 40x40 with webs and bore) replace the plain extrusion boxes in the visual layer; holes kept
2026-11-09 Sim visual layer: real-world materials by part (cast and sheet aluminium, anodised T-slot, black plastic, black cord, glossy cells), stand-in reflections in the viewer
    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
2026-11-09 Sim visual layer: head and base detail (rounded cast boxes, lid seams and screws, hex PG7 gland, lens rings and glass, bracket bolts)
    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
2026-11-09 Mast end plate: 40x40x6 aluminium plate with an M10 countersunk screw on the extrusion (6 mm shorter under it, stack top unchanged); tilt sweep clear, replica 9.58 kg; sim export follows
    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
    [interior.step, mast.step, rover.step]
2026-11-09 Sim: lunar lighting and surface (low sun, black sky with stars, regolith ground and reflection environment); sim-spec notes
    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
2026-11-09 Sim phase 2: Rapier physics (CAD mass and inertia, grouser collision hulls, differential coupling, 37D motor model with current cap, PD servos), keyboard and gamepad driving, scripted ?test=1 check, 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
2026-11-09 Terrain tool: atlas_tile.py cuts a 5x5 km tile from the LROC Atlas crater DTM with 13 sequential range requests (stops at HTTP 429); build stage tested on synthetic data
    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
2026-11-09 Terrain: site chosen by scoring all covered windows (site_select.py): tile now centred 47.3047 N, 44.8055 E (no slope over 20 degrees, 46% gentle ground, 183 m relief, several craters)
    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
2026-11-09 Sim: soil model from Hurrell et al. 2025 (FJS-1, Table 4, lunar gravity): slip-based thrust, side force and resistance per wheel, grousers off the ground contact, HUD slip and sinkage, npm run check: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
    Claude-Session: https://claude.ai/code/session_01B6dv3N11h9tKtxiwR567FV
2026-11-09 Sim: seams and shadows. Elevation model joined without a step where the Atlas ends, cubic LDEM, 10 m tile mesh, ring sunk under and drawn near the tile; terrain shadows precomputed for the fixed sun 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
2026-11-09 Sim: rocks. Boulder and stone population from the Bandfield 2011 size law scaled to Joulaud 2024's 144 per km2, instanced tiers and convex-hull colliders near the rover, soil model on ground contacts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
2026-11-09 Sim: mast camera view (picture-in-picture, IMX477 field of view checked against the Raspberry Pi documentation) and a power model (pack, loads, solar) on the HUD; camera offset fixed in the exporter 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
2026-11-09 Sim: ?sun=elevation,azimuth with terrain shadows computed in the browser, tilt guard (drive cut past 25 degrees: a wheel-high rock is not a motor stall), docs
    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
2026-11-09 Sim: surface realism after a look at other lunar simulators. No tiled texture: world-space albedo and centimetre normal noise in the shader; Lommel-Seeliger light with a shadow-hiding opposition surg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
2026-11-09 Sim: mast camera image through a sensor pass (cos^4 vignetting, Poisson-Gaussian noise, tone curve) at 640 x 480; ?vignette, ?noise, ?pip switches; docs
    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
2026-11-09 Sim: mast camera lens distortion (radial barrel, widened render so the corners are picture) and centre-weighted auto-exposure with a read-back meter; ?distort, ?ae switches; docs
    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
2026-11-09 Sim: physics in a worker (own copy of the terrain, snapshot to the page), 2048 shadow map on phones, ?stats and ?autodrive switches, DevTools-protocol screenshot script; docs
    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
2026-11-09 Sim: smaller download. Rapier only in the worker (main bundle 2.7 to 0.66 MB), elevation tile quantised to 8 cm steps (6.0 to 2.4 MB); docs
    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
2026-11-09 Sim: performance round for a laptop GPU. Adaptive pixel ratio capped at 1.5, no MSAA on retina, PCF shadows at 2048, ring split into culled chunks, clipmap rebuild spread over frames, mast camera at 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
2026-11-09 Sim: rover.glb compressed with meshopt (2.09 to 0.38 MB), decoder wired into the loader; docs
    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
2026-11-09 Sim: ?stats=1 shows the GPU name and main-thread time per frame; CDP script can profile and count frames
    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
2026-11-09 Sim: body pivots, so a node's own offset survives; fixes the camera head shifted 26 mm by the meshopt-compressed model; docs
    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
2026-11-09 Sim: minimap (M) with heading arrow, trail, scale bar; mast pan and tilt slowed to 35 deg/s (?mastrate to change); docs
    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
    [mast.step]
2026-11-09 Sim: frame pacing (even 60 Hz on faster screens), physics snapshot interpolation, camera view every second frame; the log reports frame-time spread and stutter; first benchmark log and what it showed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
2026-11-09 Sim: lens retaining ring in a pocket so its faces are not coplanar with the barrel and glass (z-fighting); model re-exported
    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
2026-11-09 Sim: interior parts merged by vertex colour (46 to 35 rover draw calls); fixed 10 m terrain level cut into 10x10 culled chunks; docs
    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
2026-11-09 Sim: re-exported, compressed rover model with the merged interior material (358 kB)
    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
2026-11-09 Sim: the camera-link cable is a simulated rope pinned to the head and the chassis, replacing the fixed mesh; docs
    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
    [headb.py]
2026-11-09 Sim: the cable rope collides with the mast column, pan housing, tilt servo, camera box and disk
    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
2026-11-09 Sim: re-exported, compressed rover model without the fixed cable mesh
    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
2026-11-09 Sim: split the HUD, camera view, touch, input and perf panel out of main.ts; docs: UI research findings and plan
    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
2026-11-09 Sim: hazard overlay (H): ground tinted by slope and rocks by height in four classes, from the tilt guard's limits
    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
2026-11-09 Sim: the mast camera view is drawn without the hazard overlay
    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
2026-11-09 Sim: mast camera view gets a compass rose, a camera roll of stills and Open MCT-style freshness flags
    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
2026-11-09 Docs: proposed overall layout for the sim interface (drone-dashboard inspired), with wireframes
2026-11-09 Sim: four modes (Drive, Plan, Camera, Data) as layout presets, with the chase view as an inset and the map or the mast camera as the main view
    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
2026-11-09 Sim: waypoint planning in Plan mode: waypoints with headings, route totals, solar heading, camera footprint, route chip, world markers, zoomable map
    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
2026-11-09 Sim: phone layouts: portrait two-row top bar and bottom sheet, panels button, tile sizes clearing the sticks, camera snap and live buttons, pinch and pan on the Plan map
    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
